lambilly/ha-monitor-display/hardware/3.5寸SPI屏幕参数1.jpg

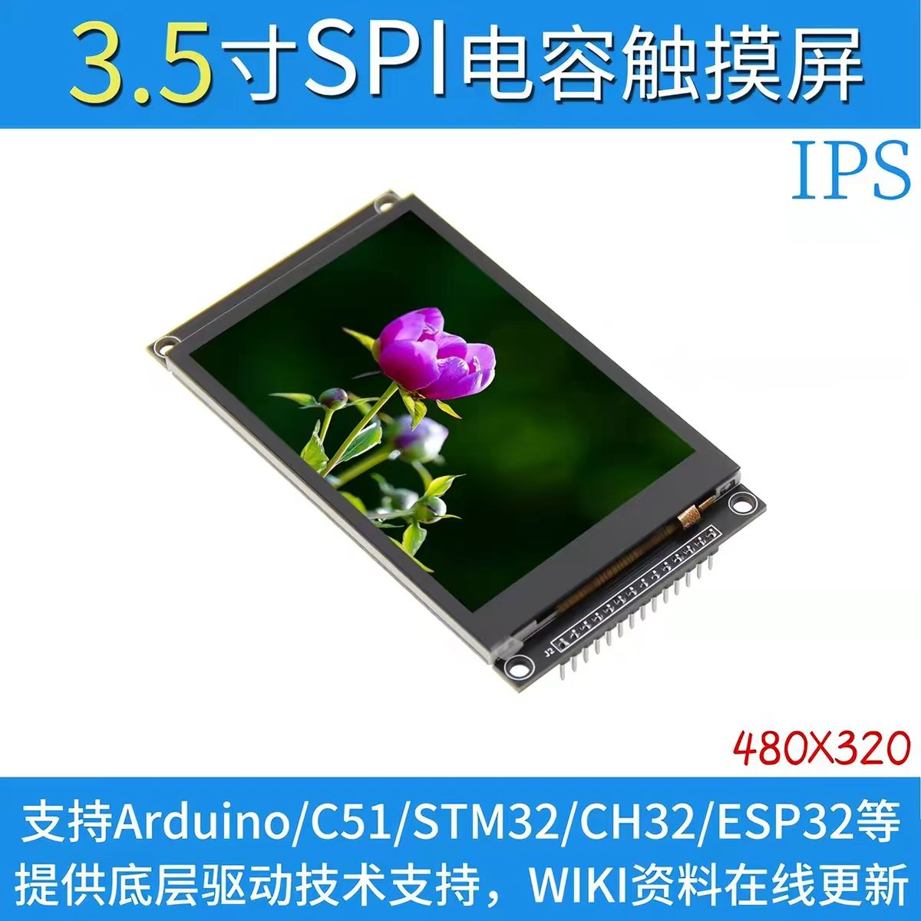
hardware/3.5寸SPI屏幕参数1.jpg
