lambilly/ha-monitor-display/hardware/INA226_1.jpg

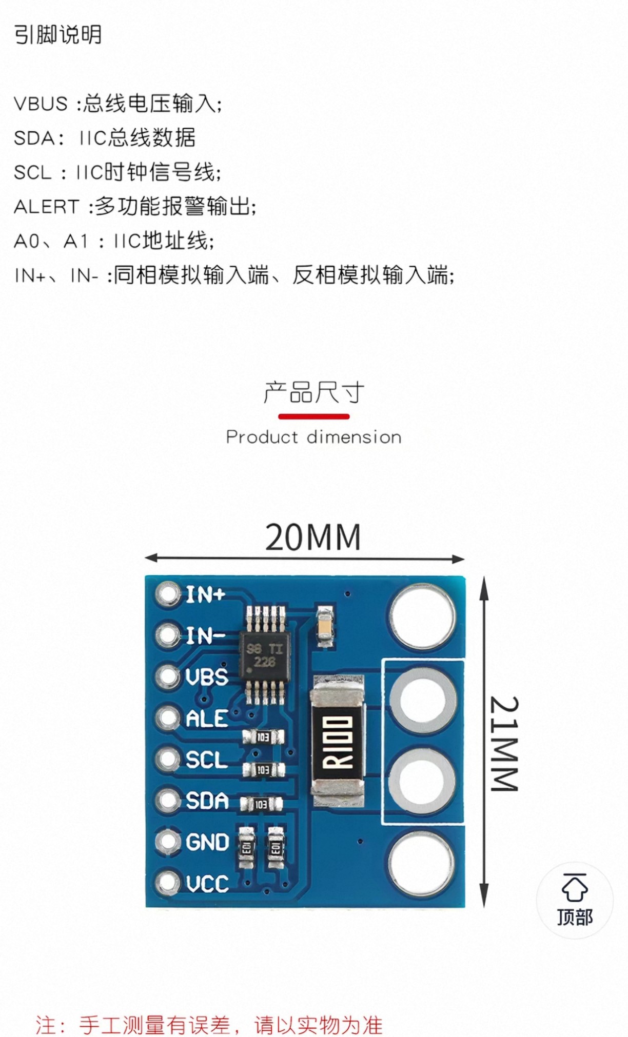
hardware/INA226_1.jpg
