lambilly/ha-monitor-display/hardware/INA226_2.jpg

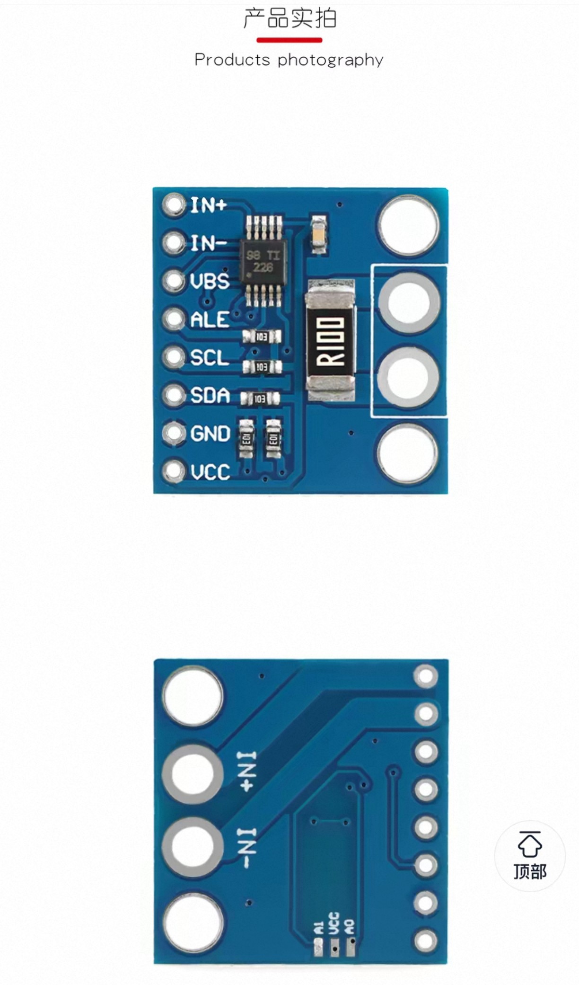
hardware/INA226_2.jpg
