lambilly/ha-monitor-display/hardware/TYPEC充电口1.png

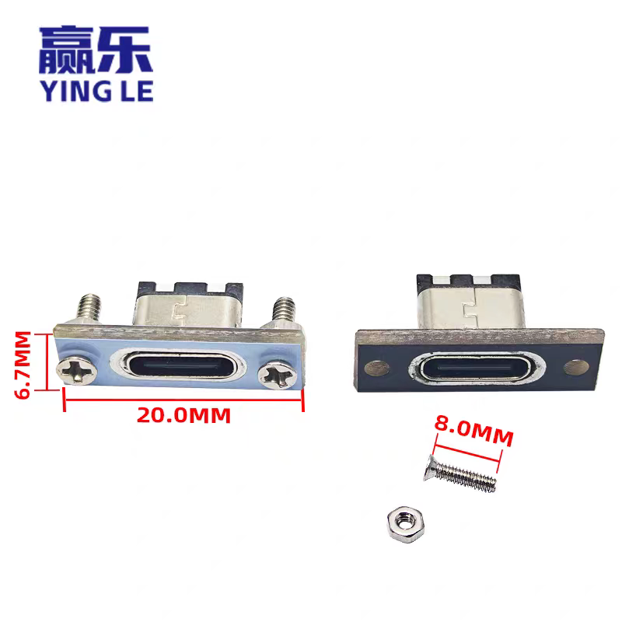
hardware/TYPEC充电口1.png
