lambilly/ha-monitor-display/hardware/TYPEC充电口2.png

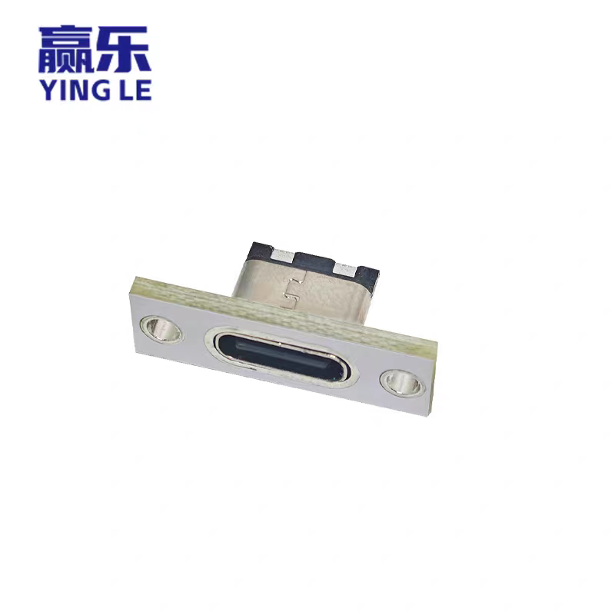
hardware/TYPEC充电口2.png
