lambilly/ha-monitor-display/hardware/屏幕镜像1-家居.png

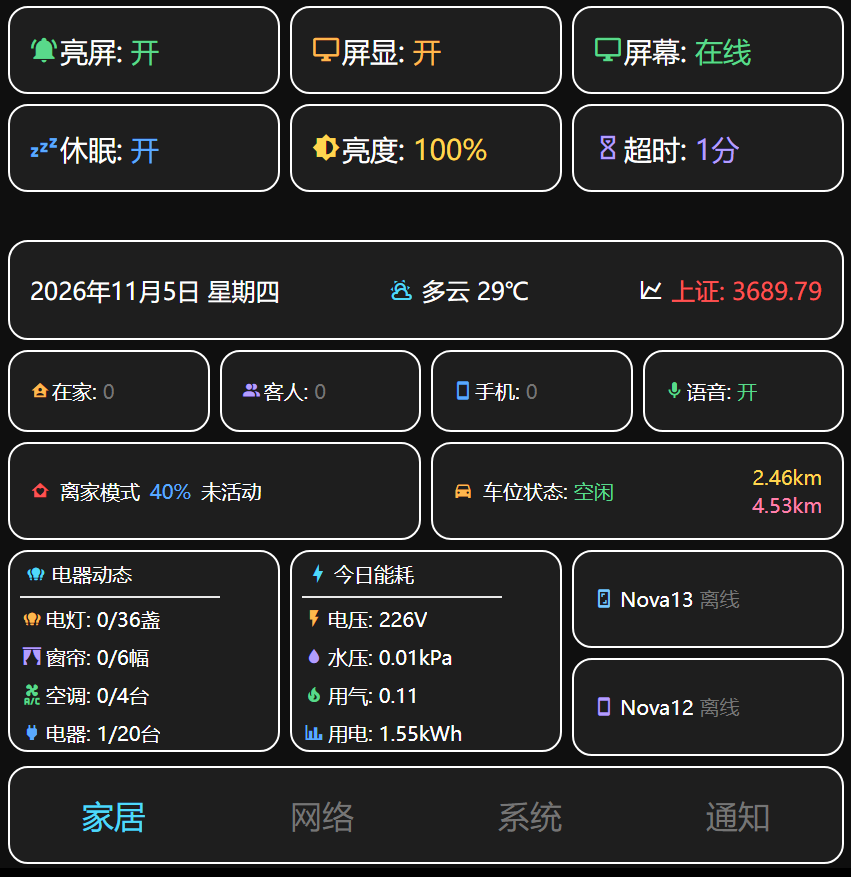
hardware/屏幕镜像1-家居.png
