lambilly/ha-monitor-display/hardware/屏幕镜像2-网络.png

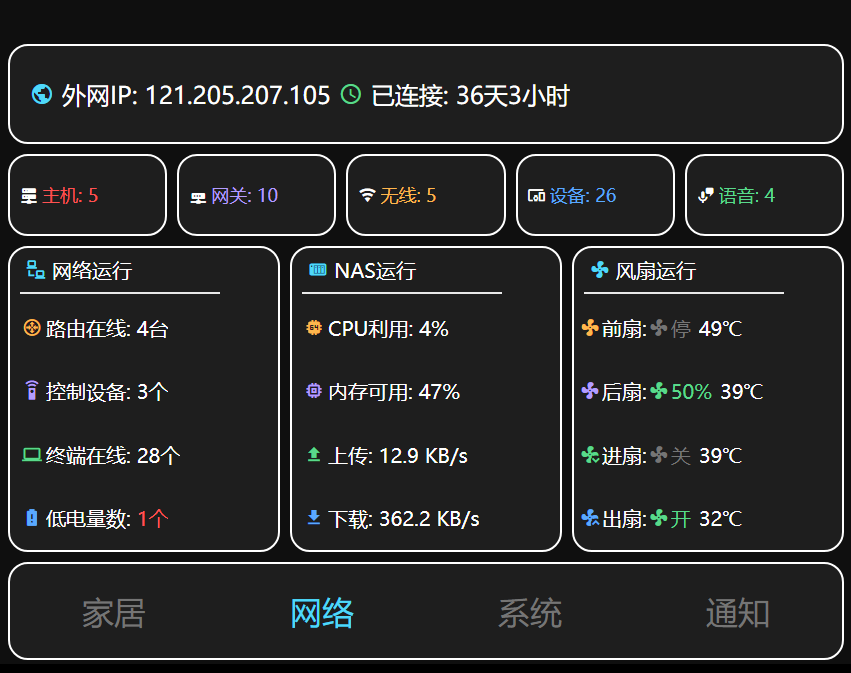
hardware/屏幕镜像2-网络.png
