lambilly/ha-monitor-display/hardware/屏幕镜像3-系统.png

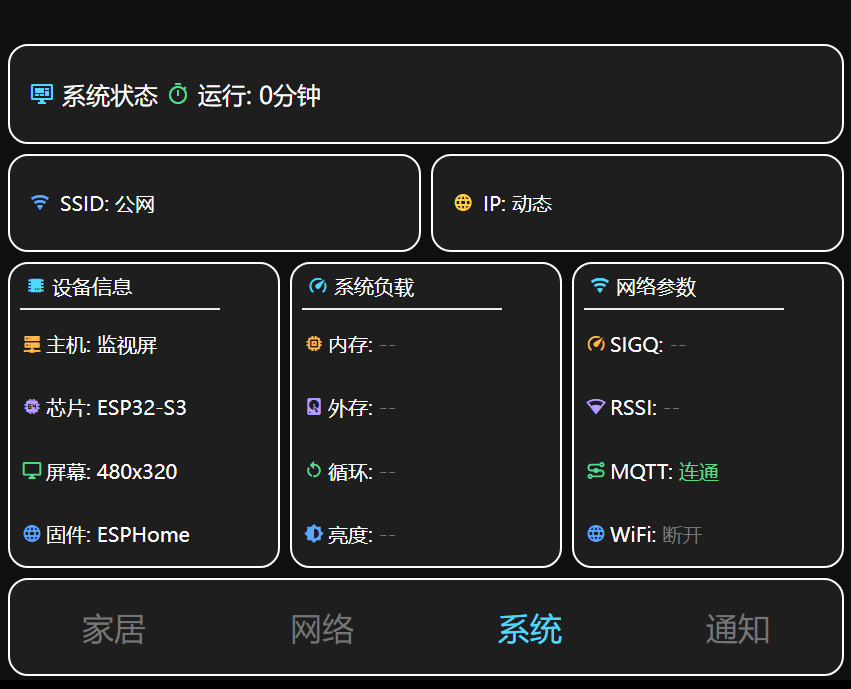
hardware/屏幕镜像3-系统.png
