lambilly/ha-monitor-display/hardware/屏幕镜像4-通知.png

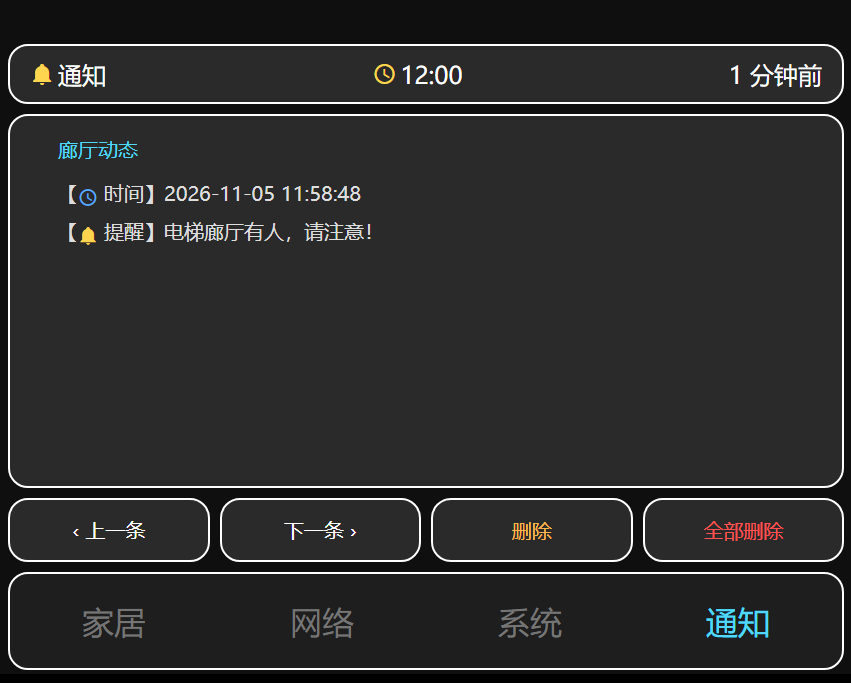
hardware/屏幕镜像4-通知.png
