lambilly/ha-monitor-display/hardware/硬件正面.jpg

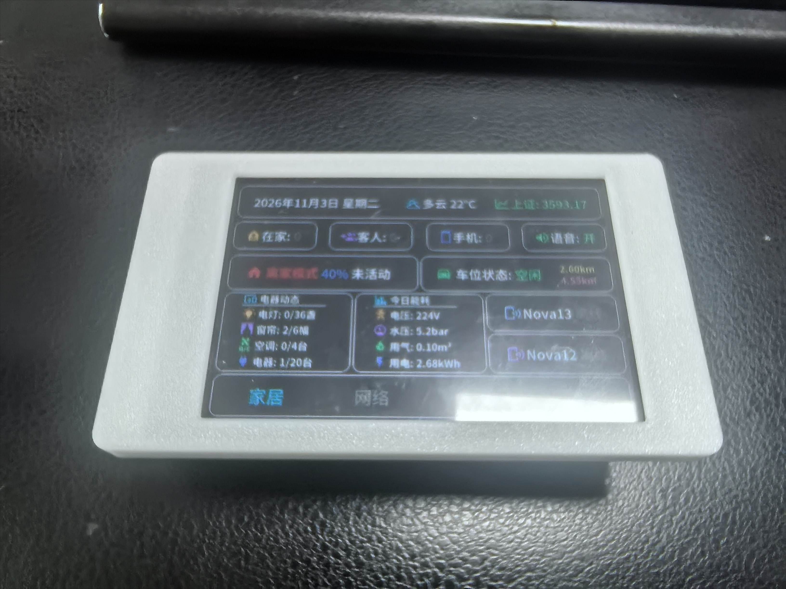
hardware/硬件正面.jpg
