lambilly/ha-monitor-display/hardware/硬件背面1.jpg

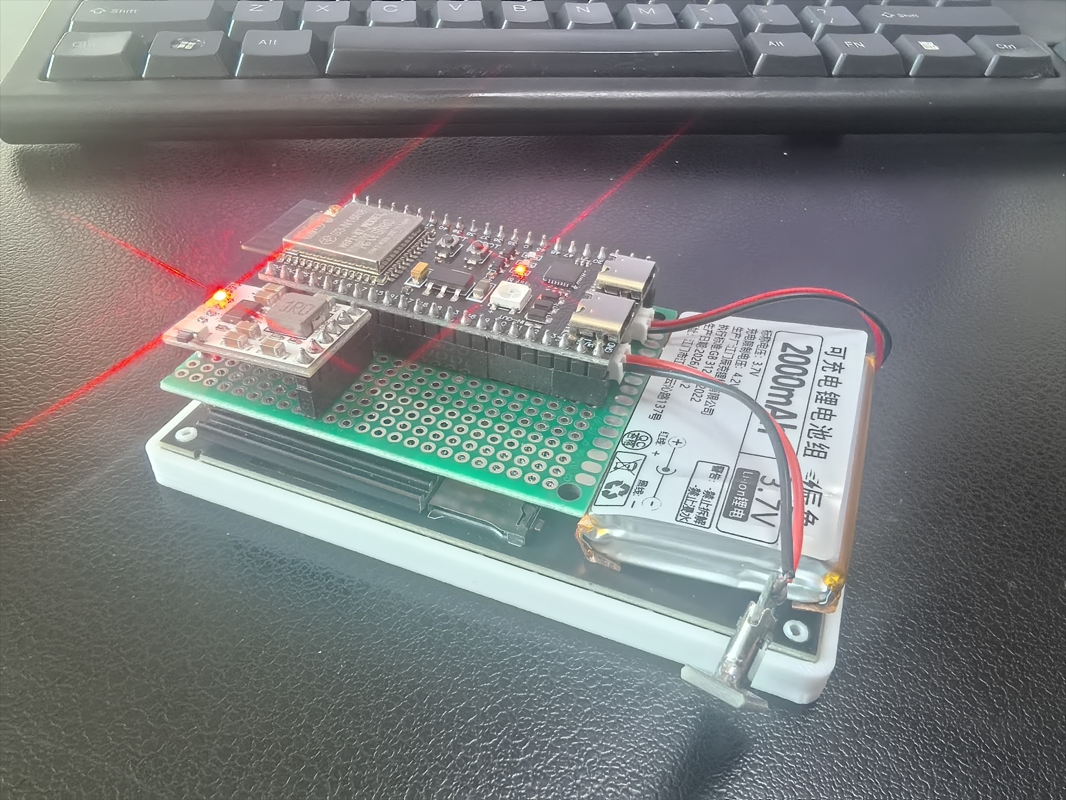
hardware/硬件背面1.jpg
