lambilly/ha-monitor-display/hardware/硬件背面2.jpg

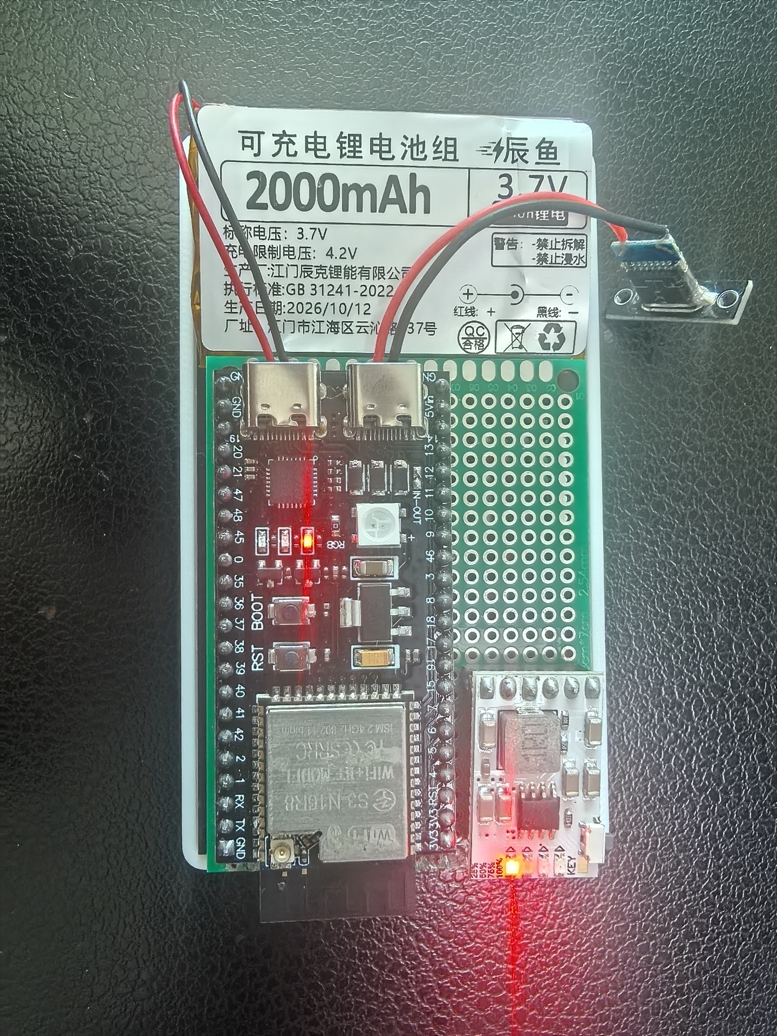
hardware/硬件背面2.jpg
