lambilly/ha-monitor-display/hardware/硬件背面.jpg

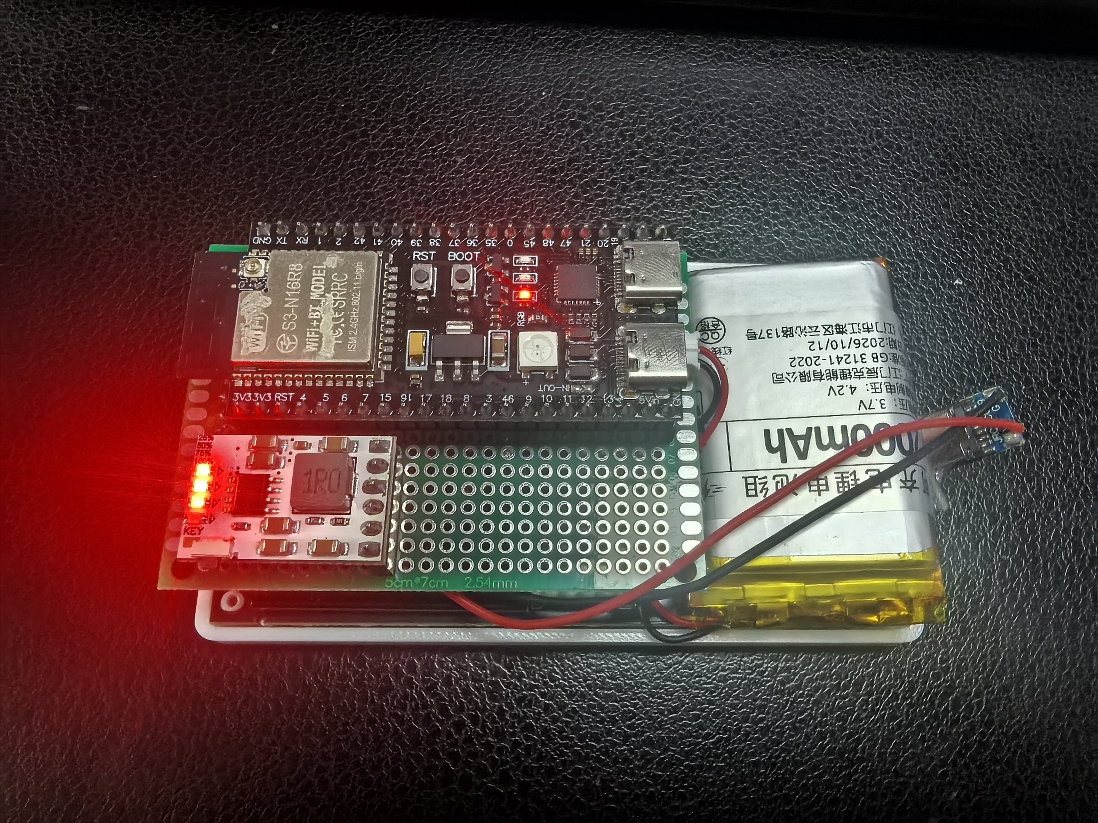
hardware/硬件背面.jpg
