lambilly/ha-monitor-display/hardware/TYPE C 母固定板.pdf

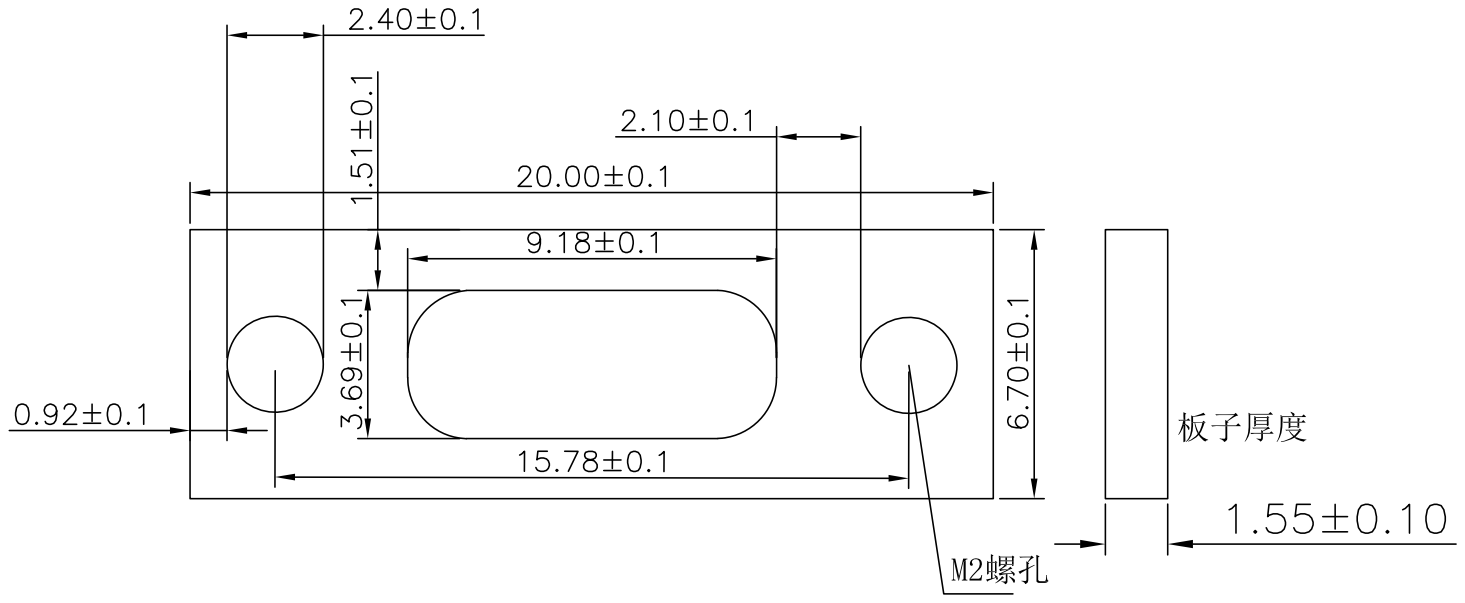
[picture p21: page 1]
