lambilly/ha-monitor-display/(list of files, drawings)

Other design files:
IP5406/KiCad/IP5406_PSU.dsn
