lambilly/ha-monitor-display/IP5406/KiCad/IP5406_PSU.kicad_pcb

## KiCad design IP5406/KiCad/IP5406_PSU.kicad_pcb (2026-11-04, last stored version)

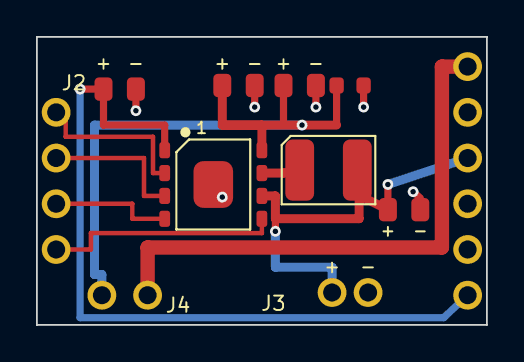
[picture p22: board IP5406_PSU.kicad_pcb from above]

Board: 2 copper layers, 25.0 x 16.0 mm, 11 parts (0 on the bottom side), 10 nets.

Parts:
C1: 22uF; C1
C2: 10uF; C2
C3: 22uF; C3
C4: 22uF; C4
C5: 100nF; C5
J1: 6PAD; J1
J2: SPARE4; J2
J3: PH2.0; J3
J4: SW_JUMPER; J4
L1: 1uH/4A; L1
U1: IP5406; U1

Connections:
BAT: C2.1, J1.3, J3.1, L1.2, U1.6
DCP: J2.1, U1.2
GND: C1.2, C2.2, C3.2, C4.2, C5.2, J1.2, J1.4, J1.5, J3.2, U1.9
KEY: J2.2, U1.3
LED1: J2.3, U1.4
LED2: J2.4, U1.5
OUT_SW: J1.1, J4.2
SW: L1.1, U1.7
VIN: C1.1, J1.6, U1.1
VOUT: C3.1, C4.1, C5.1, J4.1, U1.8
