lambilly/ha-monitor-display/ha-monitor-display.yaml

# ==========================================================
# 版本：v2.2.0 AUDIO（2026-11-07）
#   新增声音输出：MAX98357A I2S 数字功放 + 4Ω 3W 喇叭
#     · speaker(i2s_audio) → mixer → media_player(speaker)
#     · 双 pipeline（media + announcement），FLAC 由 HA 转码
#     · 内置音效 sounds/ding|notify|alarm.wav（48k/mono/16bit）
#     · SD 脚 GPIO21 空闲 3s 自动关功放（待机 <1µA）
#   上一版：v2.1 远程控制通道（HA 侧 monitor_display_control.yaml）
#   上一定版：v1.1.1（2026-11-01，续航优化，已出包）
# ==========================================================
# 主配置：设备 / 网络 / 硬件 / HA 实体
# 页面布局拆分到 ui_ha_monitor/ 目录，改界面只需改对应文件：
#   ui_ha_monitor/ui_common.yaml     公共资源（字体、全局变量、时钟刷新）
#   ui_ha_monitor/page_dashboard.yaml       页面1 家居
#   ui_ha_monitor/page_network.yaml         页面2 网络
#   ui_ha_monitor/page_system.yaml          页面3 系统
#
# ⚠️ 本项目 UI 独占 ui_ha_monitor/；口袋版 pocket-homeassistant 用 ui_pocket/，
#    两者不可混用（2026-11-12 拆分，此前共用 ui/ 导致互相覆盖）。
#
# 接入方式（方案C，双通道并存）：
#   api  : 本地局域网走 ESPHome Native API（连 Home Assistant，低延迟）
#   mqtt : 外网走 MQTT/TLS（8883），脱离 HA 也能远程读取/控制
# ==========================================================

packages:
  # 页面顺序 = LVGL 页面列表顺序，第一个为开机默认页（家居）
  page_dashboard: !include ui_ha_monitor/page_dashboard.yaml
  page_network: !include ui_ha_monitor/page_network.yaml
  page_system: !include ui_ha_monitor/page_system.yaml
  page_notify: !include ui_ha_monitor/page_notify.yaml      # v2.0 NOTIFY：第四页，不参与开机默认
  ui_common: !include ui_ha_monitor/ui_common.yaml
esphome:
  name: ha-monitor-display
  friendly_name: HA Monitor Display
  # v2.0 NOTIFY：通知环形缓冲与截断逻辑（8 槽，见 include/notify_store.h）
  includes:
    - include/notify_store.h
    - include/notify_charset.h      # notify_store.h 里 #include "notify_charset.h"，
                               # 必须一并登记，否则构建目录 src/ui/ 下没有这个文件

  # v2.1 远程控制通道：开机等 WiFi/MQTT 连上后回发一次状态帧，
  #   让 HA 里 5 个 mqtt 实体一上线就有值，不必等下一次操作。
  #   priority: -100 = 最后执行（其他 on_boot 都跑完）。
  on_boot:
    priority: -100
    then:
      - delay: 20s
      - script.execute: mqtt_pub_state

esp32:
  board: esp32-s3-devkitc-1
  variant: ESP32S3
  flash_size: 16MB
  framework:
    type: esp-idf

psram:
  mode: octal
  speed: 80MHz

logger:
  level: INFO
  logs:
    lvgl: WARN
    # 注：ESPHome 不允许某个 tag 的级别「比全局更细」
    #   （notify: DEBUG + 全局 INFO 会直接报 Failed config），
    #   所以通知链路的诊断日志一律用 ESP_LOGI，走全局 INFO 即可见。
    #   量很小：只在收到新消息、以及真的重绘时各打一两行。

api:
  encryption:
    key: !secret api_key
  # API 重连参数：网络抖动时自动恢复，不必改
  reboot_timeout: 15min

ota:
  - platform: esphome
    # 空的 encryption: 块（bare block）= 声明「OTA 必须加密，密钥继承 api 的 api_key」。
    #   ESPHome 在编译时把 api_key 填进来（见 components/esphome/ota 的 _resolve_encryption_key），
    #   所以既不会出现「密钥不一致」的校验错误，也不会被 Dashboard 判定为「另外配了一把密钥」。
    #   效果：明文 OTA 上传被拒绝；Dashboard 的两条安全提示都会消失。
    # 注意：从旧版 password 升级到加密 OTA，需 USB 线刷一次；之后无线 OTA 正常用。
    encryption:

# ==========================================================
# MQTT（外网远程通道）
# ==========================================================
mqtt:
  broker: !secret mqtt_broker      # 阿里云 DDNS 解析到你家公网 IP（地址放 secrets.yaml）
  port: !secret mqtt_port           # secrets.yaml 里配，明文 1883
  username: !secret mqtt_username
  password: !secret mqtt_password
  # topic_prefix 只影响本机"对外发布"的主题前缀。
  # 注意：本机不再向 HA 暴露任何实体（全部 internal: true），
  #       所以 discovery 关掉，避免在 HA 里生成一堆没用的空实体。
  topic_prefix: esphome/ha-monitor-display
  discovery: false
  keepalive: 30s
  reboot_timeout: 0s              
  clean_session: true
  # --- 主题规划 ---
  log_topic:
    topic: esphome/ha-monitor-display/logs
    level: INFO

  # ==========================================================
  # 订阅 HA 推送的数据帧
  # ==========================================================
  on_json_message:
    topic: home/ha-monitor-display
    then:
      - lambda: |-
          // 平铺赋值：每个 JSON key → 一个 ha_* 全局变量
          //   数值：is<float>() 判断，不可用（JSON null）时给 NAN，
          //        与页面里的 std::isfinite() 判断天然衔接
          //   布尔：| false 默认值操作符
          //   文本：is<const char *>() 判断，缺省给空串
          id(hd_ts) = x["ts"] | 0u;
          if (x["fan1_rpm"].is<float>()) id(hd_fan1_rpm) = x["fan1_rpm"].as<float>();
          else id(hd_fan1_rpm) = NAN;
          if (x["fan2_rpm"].is<float>()) id(hd_fan2_rpm) = x["fan2_rpm"].as<float>();
          else id(hd_fan2_rpm) = NAN;
          if (x["fan1_speed"].is<float>()) id(hd_fan1_speed) = x["fan1_speed"].as<float>();
          else id(hd_fan1_speed) = NAN;
          if (x["fan2_speed"].is<float>()) id(hd_fan2_speed) = x["fan2_speed"].as<float>();
          else id(hd_fan2_speed) = NAN;
          if (x["temp_front"].is<float>()) id(hd_temp_front) = x["temp_front"].as<float>();
          else id(hd_temp_front) = NAN;
          if (x["temp_back"].is<float>()) id(hd_temp_back) = x["temp_back"].as<float>();
          else id(hd_temp_back) = NAN;
          if (x["temp_in"].is<float>()) id(hd_temp_in) = x["temp_in"].as<float>();
          else id(hd_temp_in) = NAN;
          if (x["temp_out"].is<float>()) id(hd_temp_out) = x["temp_out"].as<float>();
          else id(hd_temp_out) = NAN;
          if (x["family_home"].is<float>()) id(hd_family_home) = x["family_home"].as<float>();
          else id(hd_family_home) = NAN;
          if (x["guest_visit"].is<float>()) id(hd_guest_visit) = x["guest_visit"].as<float>();
          else id(hd_guest_visit) = NAN;
          if (x["phone_online"].is<float>()) id(hd_phone_online) = x["phone_online"].as<float>();
          else id(hd_phone_online) = NAN;
          if (x["server_count"].is<float>()) id(hd_server_count) = x["server_count"].as<float>();
          else id(hd_server_count) = NAN;
          if (x["gateway_count"].is<float>()) id(hd_gateway_count) = x["gateway_count"].as<float>();
          else id(hd_gateway_count) = NAN;
          if (x["ap_count"].is<float>()) id(hd_ap_count) = x["ap_count"].as<float>();
          else id(hd_ap_count) = NAN;
          if (x["monitor_count"].is<float>()) id(hd_monitor_count) = x["monitor_count"].as<float>();
          else id(hd_monitor_count) = NAN;
          if (x["light_on"].is<float>()) id(hd_light_on) = x["light_on"].as<float>();
          else id(hd_light_on) = NAN;
          if (x["curtain_closed"].is<float>()) id(hd_curtain_closed) = x["curtain_closed"].as<float>();
          else id(hd_curtain_closed) = NAN;
          if (x["climate_on"].is<float>()) id(hd_climate_on) = x["climate_on"].as<float>();
          else id(hd_climate_on) = NAN;
          if (x["equipment_on"].is<float>()) id(hd_equipment_on) = x["equipment_on"].as<float>();
          else id(hd_equipment_on) = NAN;
          // 设备总数（HA 统计传感器属性：xxx_all_count），屏幕显示 "开/总数"
          if (x["light_all"].is<float>()) id(hd_light_all) = x["light_all"].as<float>();
          else id(hd_light_all) = NAN;
          if (x["curtain_all"].is<float>()) id(hd_curtain_all) = x["curtain_all"].as<float>();
          else id(hd_curtain_all) = NAN;
          if (x["climate_all"].is<float>()) id(hd_climate_all) = x["climate_all"].as<float>();
          else id(hd_climate_all) = NAN;
          if (x["equipment_all"].is<float>()) id(hd_equipment_all) = x["equipment_all"].as<float>();
          else id(hd_equipment_all) = NAN;
          if (x["weather_temp"].is<float>()) id(hd_weather_temp) = x["weather_temp"].as<float>();
          else id(hd_weather_temp) = NAN;
          if (x["outdoor_temp"].is<float>()) id(hd_outdoor_temp) = x["outdoor_temp"].as<float>();
          else id(hd_outdoor_temp) = NAN;
          if (x["energy_today"].is<float>()) id(hd_energy_today) = x["energy_today"].as<float>();
          else id(hd_energy_today) = NAN;
          if (x["gas_today"].is<float>()) id(hd_gas_today) = x["gas_today"].as<float>();
          else id(hd_gas_today) = NAN;
          if (x["voltage"].is<float>()) id(hd_voltage) = x["voltage"].as<float>();
          else id(hd_voltage) = NAN;
          if (x["water_pressure"].is<float>()) id(hd_water_pressure) = x["water_pressure"].as<float>();
          else id(hd_water_pressure) = NAN;
          if (x["xuanyi_dist"].is<float>()) id(hd_xuanyi_dist) = x["xuanyi_dist"].as<float>();
          else id(hd_xuanyi_dist) = NAN;
          if (x["byd_dist"].is<float>()) id(hd_byd_dist) = x["byd_dist"].as<float>();
          else id(hd_byd_dist) = NAN;
          if (x["wan_uptime"].is<float>()) id(hd_wan_uptime) = x["wan_uptime"].as<float>();
          else id(hd_wan_uptime) = NAN;
          if (x["asr_count"].is<float>()) id(hd_asr_count) = x["asr_count"].as<float>();
          else id(hd_asr_count) = NAN;
          if (x["router_count"].is<float>()) id(hd_router_count) = x["router_count"].as<float>();
          else id(hd_router_count) = NAN;
          if (x["device_ctrl"].is<float>()) id(hd_device_ctrl) = x["device_ctrl"].as<float>();
          else id(hd_device_ctrl) = NAN;
          if (x["terminal_count"].is<float>()) id(hd_terminal_count) = x["terminal_count"].as<float>();
          else id(hd_terminal_count) = NAN;
          if (x["low_battery"].is<float>()) id(hd_low_battery) = x["low_battery"].as<float>();
          else id(hd_low_battery) = NAN;
          if (x["nas_cpu"].is<float>()) id(hd_nas_cpu) = x["nas_cpu"].as<float>();
          else id(hd_nas_cpu) = NAN;
          if (x["nas_mem"].is<float>()) id(hd_nas_mem) = x["nas_mem"].as<float>();
          else id(hd_nas_mem) = NAN;
          if (x["screen_bright"].is<float>()) id(hd_screen_bright) = x["screen_bright"].as<float>();
          else id(hd_screen_bright) = NAN;
          if (x["nas_download"].is<float>()) id(hd_nas_download) = x["nas_download"].as<float>();
          else id(hd_nas_download) = NAN;
          if (x["nas_upload"].is<float>()) id(hd_nas_upload) = x["nas_upload"].as<float>();
          else id(hd_nas_upload) = NAN;

          // 开关类三态：-1=实体不存在/无数据，0=关，1=开
          //（HA 侧宏 sw() 在实体不可用时输出 null，此处落成 -1）
          // 在线设备指示两格（通用槽位，名称由 HA 下发，固件不写死任何具体设备）
          id(hd_device_a_online) = x["device_a_online"].is<int>() ? x["device_a_online"].as<int>() : -1;
          id(hd_device_b_online) = x["device_b_online"].is<int>() ? x["device_b_online"].as<int>() : -1;
          id(hd_wan_status)      = x["wan_status"].is<int>()      ? x["wan_status"].as<int>()      : -1;
          id(hd_voice_broadcast) = x["voice_broadcast"].is<int>() ? x["voice_broadcast"].as<int>() : -1;
          id(hd_fan_in_switch)   = x["fan_in_switch"].is<int>()   ? x["fan_in_switch"].as<int>()   : -1;
          id(hd_fan_out_switch)  = x["fan_out_switch"].is<int>()  ? x["fan_out_switch"].as<int>()  : -1;

          id(hd_time_text) = x["time_text"].is<const char *>() ? std::string(x["time_text"].as<const char *>()) : std::string();
          // 在线设备两格的显示名称（HA 下发；留空则界面用默认「设备1/设备2」）
          id(hd_device_a_name) = x["device_a_name"].is<const char *>() ? std::string(x["device_a_name"].as<const char *>()) : std::string();
          id(hd_device_b_name) = x["device_b_name"].is<const char *>() ? std::string(x["device_b_name"].as<const char *>()) : std::string();
          id(hd_external_ip) = x["external_ip"].is<const char *>() ? std::string(x["external_ip"].as<const char *>()) : std::string();
          id(hd_weather) = x["weather"].is<const char *>() ? std::string(x["weather"].as<const char *>()) : std::string();
          id(hd_stock) = x["stock"].is<const char *>() ? std::string(x["stock"].as<const char *>()) : std::string();
          // 上证涨跌幅：JSON 数字直接取；HA 若发字符串（如 "0.35"）用 atof 兜底；null/缺失 → NAN（界面显灰）
          if (x["stock_chg"].is<float>())             id(hd_stock_chg) = x["stock_chg"].as<float>();
          else if (x["stock_chg"].is<const char *>()) id(hd_stock_chg) = atof(x["stock_chg"].as<const char *>());
          else                                        id(hd_stock_chg) = NAN;
          id(hd_home_mode) = x["home_mode"].is<const char *>() ? std::string(x["home_mode"].as<const char *>()) : std::string();
          id(hd_activity_log) = x["activity_log"].is<const char *>() ? std::string(x["activity_log"].as<const char *>()) : std::string();
          // 音量百分比：数字直接用；HA 若发 "65%"/"65" 之类字符串则提数字；null/缺失/非数字 → NAN
          {
            float mv = NAN;
            if (x["mode_volume"].is<float>()) {
              mv = x["mode_volume"].as<float>();
            } else if (x["mode_volume"].is<const char *>()) {
              const char *p = x["mode_volume"].as<const char *>();
              if (p != nullptr && ((p[0] >= '0' && p[0] <= '9') || p[0] == '-')) mv = atof(p);
            }
            id(hd_mode_volume) = std::isfinite(mv) ? mv : NAN;
            static bool mv_warned = false;
            if (!std::isfinite(mv) && !mv_warned) {
              mv_warned = true;
              ESP_LOGW("ha_data", "mode_volume 缺失或非数值（HA 侧 sensor.ju_jia_mo_shi 无 volume_percent 属性？）");
            }
          }
          id(hd_parking_status) = x["parking_status"].is<const char *>() ? std::string(x["parking_status"].as<const char *>()) : std::string();

          id(ha_data_last_ms) = millis();
          ESP_LOGD("ha_data", "收到数据帧 ts=%u", (unsigned) id(hd_ts));

  # ==========================================================
  # 订阅通知消息（v2.0 NOTIFY）
  # ----------------------------------------------------------
  #   主题 home/ha-monitor-display/notify，QoS1，retain=false。
  #   MQTT 主题精确匹配，上面的数据帧订阅收不到子主题，两条互不干扰。
  #   载荷优先按 JSON {title,message,ts} 解析（Node-RED 子流程的格式）；
  #   不是 JSON 就整段当正文，HA 原生 mqtt.publish 发纯文本也能上屏。
  #   入库统一走 ns_notify（include/notify_store.h）：8 槽环形 + UTF-8 安全截断 + 重复丢弃。
  # ==========================================================
  on_message:
    - topic: home/ha-monitor-display/notify
      then:
        - lambda: |-
            std::string nt;
            std::string nm;
            uint32_t nts = 0;
            bool parsed = false;

            if (!x.empty() && x[0] == '{') {
              parsed = esphome::json::parse_json(x, [&](JsonObject root) -> bool {
                if (root["title"].is<const char *>()) nt = root["title"].as<const char *>();
                if (root["message"].is<const char *>()) nm = root["message"].as<const char *>();
                // ts 统一归一成「秒」：Node-RED 里 Date.now() 给的是 13 位毫秒，
                //   直接塞进 uint32_t 会溢出成乱七八糟的值（时间显示错乱甚至空白），
                //   所以先按 64 位读，超过 1e11 就除 1000。
                if (root["ts"].is<const char *>()) {
                  const unsigned long long raw =
                      strtoull(root["ts"].as<const char *>(), nullptr, 10);
                  nts = static_cast<uint32_t>(raw > 100000000000ULL ? raw / 1000 : raw);
                } else if (!root["ts"].isNull()) {
                  const uint64_t raw = root["ts"].as<uint64_t>();
                  nts = static_cast<uint32_t>(raw > 100000000000ULL ? raw / 1000 : raw);
                }
                return true;
              });
            }
            if (!parsed || (nt.empty() && nm.empty())) {
              nt.clear();
              nm = x;                                  // 非 JSON 载荷：整段当正文
            }
            if (nt.empty() && nm.empty()) return;

            // 诊断（第九轮加）：入库前的「原始」message 有几个换行 ——
            //   0 个 = 换行在上游（HA 模板 / NR 上游节点）就丢了，设备端无从恢复；
            //   >0 个但入库后变少 = 设备端处理链有问题（目前没有这种迹象）。
            {
              int raw_nl = 0;
              for (size_t k = 0; k < nm.size(); k++)
                if (nm[k] == '\n') raw_nl++;
              ESP_LOGI("notify", "原始 message %u字节/%d个换行 标题[%s]",
                       (unsigned) nm.size(), raw_nl, nt.c_str());
            }

            // 去重在 push 内部做（要拿归一 + 折行后的值比才准，见 notify_store.h）
            ns_notify::push(nt, nm, nts);
            {
              // 诊断日志（用户 11-01 要求抓串口）：一行看完入库结果
              //   正文 N 字节 / M 行 —— 行数是数 '\n' 得来的
              //   若 行数=1 而字节数很大，说明 wrap_hard 没跑到（折行没生效）
              //   再往下一条「全文」把正文原样吐出来，串口里会真的断成多行
              const std::string &mm = ns_notify::at(0).msg;
              int nl = 0;
              for (size_t k = 0; k < mm.size(); k++)
                if (mm[k] == '\n') nl++;
              ESP_LOGI("notify", "入列 共%d条 未读%d条 [%s] 正文%u字节/%d行 首行:%.46s",
                       ns_notify::count, ns_notify::unread,
                       ns_notify::at(0).title.c_str(),
                       (unsigned) mm.size(), nl + 1, mm.c_str());
              ESP_LOGI("notify", "全文:\n%s", mm.c_str());
            }

            // 通知亮屏与跳页见下方动作链（v3.3）：这里只管入库
        # ==========================================================
        # 通知亮屏并直跳通知页（v3.3）
        #   以前只唤醒背光，15 秒里停在原页面，用户得先摸一下 TAB 才看得见通知。
        #   现在：关屏状态下收到通知 → 切 notify_page + 唤醒（保持 15s，见 wake_screen）。
        #   · 条件里带 ui_screen_off：屏亮着时不抢页面，避免用户正看家居页被顶走；
        #   · lvgl.page.show 必须走动作队列，不能在 MQTT 回调的 lambda 里直接 lv_scr_load；
        #   · notify_page 的 on_load 会自动置 ui_current_page=4 并清未读，TAB 高亮同步。
        # ==========================================================
        - if:
            condition:
              lambda: 'return id(notify_wake_on_msg).state && id(ui_screen_off) && id(lvgl_ready);'
            then:
              - lvgl.page.show: notify_page
              - script.execute: wake_screen

    # ==========================================================
    # v2.1 远程控制通道（屏幕带出门后仍可控制）
    # ----------------------------------------------------------
    #   痛点：亮度/亮屏时间/两个开关原先只走 Native API，要求 HA 能
    #     主动连到屏幕。屏幕一出门（无公网 IP、穿过 NAT）这条线就断，
    #     而 MQTT 是设备主动往外连，所以数据一直好、控制全废。
    #   做法：把这 5 项也挂到 MQTT 上，payload 就是简单值，
    #     应用后立刻回发状态帧（retain），HA 面板实时跟随。
    #   主题（全部 retain，QoS1）：
    #     .../cmd/light     ON | OFF                屏幕开关（开=唤醒到上次亮度）
    #     .../cmd/bright    10~100                  亮度百分比
    #     .../cmd/sleep     15~900                  熄屏超时（秒）
    #     .../cmd/autosleep ON | OFF                自动休眠总开关
    #     .../cmd/wake      ON | OFF                收到通知时亮屏
    #   注：cmd 主题 retain，所以设备重连/重启会重放 HA 最后一次下发的值，
    #     即「重启后以 HA 侧为准」，比本机 restore_value 更可预期。
    # ==========================================================
    - topic: home/ha-monitor-display/cmd/light
      qos: 1
      then:
        - lambda: |-
            const bool on = (x == "ON" || x == "on" || x == "1");
            ESP_LOGI("cmd", "remote light -> %s", on ? "ON" : "OFF");
            if (on) {
              if (id(ui_screen_off)) {
                id(wake_screen).execute();
              } else {
                auto call = id(lcd_backlight).turn_on();
                call.set_brightness(id(ui_saved_brightness));
                call.perform();
              }
            } else {
              id(sleep_screen).execute();
            }
        - script.execute: mqtt_pub_state

    - topic: home/ha-monitor-display/cmd/bright
      qos: 1
      then:
        - lambda: |-
            auto v = esphome::parse_number<float>(x);
            if (!v.has_value()) return;
            float pct = *v;
            if (pct < 10.0f) pct = 10.0f;      // 与滑块实体 min 一致，防调到看不见
            if (pct > 100.0f) pct = 100.0f;
            ESP_LOGI("cmd", "remote brightness -> %.0f%%", pct);
            // 直接走滑块实体的 set_action：ui_saved_brightness 与灯实体一次到位
            auto call = id(screen_brightness_number).make_call();
            call.set_value(pct);
            call.perform();
        - script.execute: mqtt_pub_state

    - topic: home/ha-monitor-display/cmd/sleep
      qos: 1
      then:
        - lambda: |-
            auto v = esphome::parse_number<float>(x);
            if (!v.has_value()) return;
            float s = *v;
            if (s < 15.0f) s = 15.0f;
            if (s > 900.0f) s = 900.0f;
            ESP_LOGI("cmd", "remote sleep timeout -> %.0fs", s);
            auto call = id(sleep_timeout_number).make_call();
            call.set_value(s);
            call.perform();
        - script.execute: mqtt_pub_state

    - topic: home/ha-monitor-display/cmd/autosleep
      qos: 1
      then:
        - lambda: |-
            const bool on = (x == "ON" || x == "on" || x == "1");
            ESP_LOGI("cmd", "remote auto sleep -> %s", on ? "ON" : "OFF");
            if (on) id(auto_sleep_switch).turn_on();
            else id(auto_sleep_switch).turn_off();
        - script.execute: mqtt_pub_state

    - topic: home/ha-monitor-display/cmd/wake
      qos: 1
      then:
        - lambda: |-
            const bool on = (x == "ON" || x == "on" || x == "1");
            ESP_LOGI("cmd", "remote notify wake -> %s", on ? "ON" : "OFF");
            if (on) id(notify_wake_on_msg).turn_on();
            else id(notify_wake_on_msg).turn_off();
        - script.execute: mqtt_pub_state

wifi:
  ssid: !secret wifi_ssid
  password: !secret wifi_password
  # modem-sleep：无流量时 WiFi 进省电态，待机电流约省 1/3。
  # 代价仅是响应略慢（数据帧 5s 一推，感知不到），MQTT keepalive 15s 不受影响。
  power_save_mode: light
  ap:
    ssid: HA Monitor Fallback
    password: !secret ap_password

captive_portal:
web_server:
  port: 80
  version: 3
  auth:
    # digest：密码只以哈希形式走网络（basic 是 Base64，等于明文）
    # 2027.1.0 起 ESPHome 的默认值也会变成 digest，现在显式指定可提前对齐。
    # 注意：用 curl 等 REST 客户端访问需加 --digest（例：curl --digest -u admin:密码 http://IP/）。
    type: digest
    username: admin
    password: !secret web_password

# --- 屏幕硬件配置 ---
spi:
  id: display_spi
  clk_pin: GPIO12
  mosi_pin: GPIO11
  miso_pin: GPIO13

i2c:
  id: touch_i2c
  scl: GPIO6
  sda: GPIO7
  frequency: 100kHz

output:
  - platform: ledc
    pin:
      number: GPIO15
    id: lcd_backlight_pwm
    frequency: 20kHz

light:
  - platform: monochromatic
    id: lcd_backlight
    name: "Screen Light"
    icon: mdi:monitor
    output: lcd_backlight_pwm
    # ALWAYS_OFF：开机不自带满亮点亮，由 lvgl on_boot 按 ui_saved_brightness（默认 60%）点亮，
    # 避免开机先全亮一秒再暗下来的闪变。休眠/唤醒见 script sleep_screen / wake_screen。
    restore_mode: ALWAYS_OFF

display:
  - platform: mipi_spi
    id: lcd_display
    model: CUSTOM
    dimensions: 320x480
    spi_id: display_spi
    cs_pin: GPIO10
    dc_pin: GPIO9
    reset_pin: GPIO8
    data_rate: 40MHz
    transform:
      mirror_x: true
      mirror_y: false
      swap_xy: false
    rotation: 0
    color_order: bgr
    invert_colors: true
    auto_clear_enabled: false
    update_interval: never
    init_sequence:
      - [0xF0, 0xC3]
      - [0xF0, 0x96]
      - [0xB4, 0x02]
      - [0xB7, 0xC6]
      - [0xC0, 0xC0, 0x00]
      - [0xC1, 0x13]
      - [0xC2, 0xA7]
      - [0xC5, 0x21]
      - [0xE8, 0x40, 0x8A, 0x1B, 0x1B, 0x23, 0x0A, 0xAC, 0x33]
      - [0xE0, 0xD2, 0x05, 0x08, 0x06, 0x05, 0x02, 0x2A, 0x44, 0x46, 0x39, 0x15, 0x15, 0x2D, 0x32]
      - [0xE1, 0x96, 0x08, 0x0C, 0x09, 0x09, 0x25, 0x2E, 0x43, 0x42, 0x35, 0x11, 0x11, 0x28, 0x2E]
      - [0xF0, 0x3C]
      - [0xF0, 0x69]

touchscreen:
  - platform: ft63x6
    id: touch_panel
    i2c_id: touch_i2c
    address: 0x38
    display: lcd_display
    reset_pin: GPIO5
    update_interval: 20ms
    on_touch:
      - lambda: id(ui_touch_active) = true;
      # 熄屏状态下任意触摸立即点亮
      - if:
          condition:
            lambda: return id(ui_screen_off);
          then:
            - script.execute: wake_screen
    on_release:
      - lambda: id(ui_touch_active) = false;

# ==========================================================
# 声音输出：MAX98357A（I2S 数字功放）  v2.2.0 新增 2026-11-07
#   接线：VIN→5V(J1-1) / GND→GND(J1-2)
#         BCLK→GPIO39 / LRC→GPIO40 / DIN→GPIO41 / SD→GPIO21
#         喇叭 ± 接 BTL 输出——**两端都不可接地**，否则烧功放
#   省电：SD 由 GPIO21 控制，不播放时拉低 → 功放待机 <1µA
#         （悬空或接 VDD 会常耗 2.4mA，对 20mA 待机是 +12%）
#   引脚全部选在模块**右侧**，与左侧的 SPI(11/12/13) 和 I2C(6/7) 分开，
#     避免 BCLK 与 SCK(40MHz) 长距离并行串扰，走线也顺。
#     ⚠️ 原选 47/48/38 已废弃（v2.2.1 换掉），两个原因：
#        ① 47/48/38 正是 DevKitC-1 板载 WS2812 彩灯的脚（v1.0=48 / v1.1=38），
#          I2S 位流被 WS2812 误解析 → 灯变纯白常亮，且给数据线挂负载；
#        ② 若是 WROOM-2（N16R8V），GPIO47/48 在 VDD_SPI 1.8V 域，输出仅 1.8V，
#          驱动 MAX98357A(VIH=1.3V) 余量太小。
#     39/40/41 是 JTAG 复用脚，ESPHome 不用 JTAG（UART/OTA 烧录），可安全占用。
#     避开的：35/36/37(octal PSRAM)、19/20(USB)、0/3/45/46(strapping)、
#             43/44(UART0)、4(TF 卡预留，且已加 10k 上拉)
# ==========================================================
i2s_audio:
  # 注意：i2s_audio 是单实例组件（不是列表，写成 `- id:` 会校验失败）
  id: i2s_out
  i2s_lrclk_pin: GPIO40
  i2s_bclk_pin: GPIO39

speaker:
  - platform: i2s_audio
    id: spk_out
    i2s_audio_id: i2s_out
    i2s_dout_pin: GPIO41
    dac_type: external            # MAX98357A = 外部 DAC + D 类功放
    sample_rate: 48000
    bits_per_sample: 16bit
    channel: mono                 # 单喇叭，单声道省一半带宽与解码开销
    buffer_duration: 300ms
    timeout: 500ms

  # mixer：把「媒体」与「播报」两条流水线合成一路送给同一个喇叭。
  # 必须用 mixer —— ESPHome 不允许两条 pipeline 指向同一个 speaker 实例。
  # 两条都是 48kHz / mono，采样率一致，所以不需要 resampler。
  - platform: mixer
    id: spk_mix
    output_speaker: spk_out
    task_stack_in_psram: true
    source_speakers:
      - id: spk_media_in            # TTS / 音乐 / play_media 走这条
      - id: spk_announce_in         # 紧急播报走这条（可 ducking 压低媒体音量）

media_player:
  - platform: speaker
    id: mp_screen
    name: "Screen Speaker"
    icon: mdi:speaker
    # announcement_pipeline 在 schema 里是 Required，media 才是 Optional；
    # 两条都配上，TTS(走 media) 与紧急播报(走 announcement) 才能分别工作。
    media_pipeline:
      speaker: spk_media_in
      format: FLAC                # HA(≥2024.10) 负责转码，设备端只解码，省 CPU
      sample_rate: 48000
      num_channels: 1
    announcement_pipeline:
      speaker: spk_announce_in
      format: FLAC
      sample_rate: 48000
      num_channels: 1
    buffer_size: 120000           # 每条流水线 120KB（大块 malloc 落 PSRAM）
    task_stack_in_psram: true     # 8MB octal PSRAM，任务栈不占内部 RAM
    volume_initial: 60%
    # ⚠️ 上限压到 70%，不是 90%：
    #   4Ω/3W 喇叭在 5V 下满量程 3.2W，峰值电流 ≈1.26A@4Ω，
    #   电池 3.99V 要输出 1.7A 输入，会直接踩 IP5407 的过流/欠压打嗝。
    #   70% 音量 ≈ 1.5W 峰值，电池撑得住，响度对室内信息屏已经够。
    volume_max: 70%
    files:                        # 内置音效：断网 / HA 宕机也能响
      - id: snd_ding
        file: sounds/ding.wav
      - id: snd_notify
        file: sounds/notify.wav
      - id: snd_alarm
        file: sounds/alarm.wav

# 内置音效的调用方式（v2.2.1 删掉了 3 个 template button —— 它们只是手动试音键，
# 与 media_player 实体功能重复；自动化直接调下面的动作即可，能力一点没少）
# HA 自动化里要响，直接调动作：
#   action: media_player.speaker.play_on_device_media_file
#   data: { entity_id: media_player.ha_monitor_display_screen_speaker, media_file: snd_ding }
# TTS 播报：action: tts.speak（target: media_player.ha_monitor_display_screen_speaker）

# --- 时间 ---
# ==========================================================
# 时间：只用 SNTP，不依赖 HA
#   （原 platform: homeassistant 的 time 也需要 Native API，
#     出门后不可用；SNTP 只要设备能上网就能对时）
# ==========================================================
time:
  - platform: sntp
    id: system_time
    timezone: Asia/Shanghai
    servers:
      - ntp.aliyun.com
      - cn.pool.ntp.org
      - time.cloudflare.com

lvgl:
  displays: [lcd_display]
  touchscreens: [touch_panel]
  rotation: 270                     # 横屏 480x320（竖装倒置：由 90 翻 180°）
  buffer_size: "25%"
  draw_rounding: 8
  resume_on_input: false
  on_boot:
    - delay: 800ms
    - lambda:
        ESP_LOGI("custom", "LVGL is ready!");
        id(lvgl_ready) = true;
    # 开机默认进入家居页
    - lvgl.page.show: dashboard_page
    # 开机点亮背光：亮度取 ui_saved_brightness（默认 60%，熄屏恢复同源）
    - light.turn_on:
        id: lcd_backlight
        brightness: !lambda |-
          return id(ui_saved_brightness);
  default_font: ui_font_small
  theme:
    label:
      pressed:
        text_color: 0xFFFFFF

  # ==========================================================
  # 全局顶层：数据通道离线指示
  # ----------------------------------------------------------
  top_layer:
    widgets:
      # 离线图标（默认隐藏，由下方 interval 控制显隐）
      # mdi:cloud-off（实心断云）U+F1BF6；
      - label:
          id: offlink_icon
          align: TOP_RIGHT
          x: -9
          y: 6
          text: "\U000F1BF6"
          text_font: mdi_icons_12
          text_color: 0xFF5252
          hidden: true
      # 离线文字（与图标同一行，靠左显示"离线"两字）
      - label:
          id: offlink_text
          align: TOP_RIGHT
          x: -26
          y: 4
          text: "离线"
          text_font: ui_font_small
          text_color: 0xFF5252
          hidden: true

      # 未读红点（v2.0 NOTIFY）：压在 TAB「通知」键的右上角
      #   放在 top_layer 而不是 tab_bar.yaml 里 —— 片段被四页各 include 一次，
      #   带 id 会重复定义；这里单实例，四个页面顶部都能看到同一个点。
      #   x 跟着 TAB 走：TAB 第八轮右移 7px（≈1.2mm，通知键墨迹 379~419）
      #   第十轮：用户说「有新通知时能不能在 TAB 通知那里做个记号」——
      #   原来这个点只有 6px、还没描边，压在深色底上几乎看不见。改成 9px
      #   圆点 + 1px 深色描边（任何背景色下都能看出边界）。
      #   第十二轮（用户实测）：9px 时点儿落在「通知」两字正中间的上方，
      #   右移 18px、下移 2px 挪到两字右上角，同时放大到 11px 更好认。
      #   第十三轮：再左 1px、下 1px（439/273→438/274）；红点改浅绿 59D98B
      #   —— 红点在深色底上太像告警，绿点更接近「有新内容」的语义。
      - obj:
          id: notify_badge
          align: TOP_LEFT
          x: 438
          y: 274
          width: 11
          height: 11
          bg_color: 0x59D98B
          border_width: 1
          border_color: 0x1E1E1E
          outline_width: 0
          radius: 6
          scrollable: false
          hidden: true

# ==========================================================
# 未读红点巡检（v2.0 NOTIFY）
#   只看 unread 变化，没变化直接 return；进通知页即视为已读
# ==========================================================
interval:
  - interval: 1s
    then:
      - lambda: |-
          if (!id(lvgl_ready)) return;
          static int last_unread = -1;
          const int u = (id(ui_current_page) == 4) ? 0 : ns_notify::unread;
          if (u == last_unread) return;
          last_unread = u;
          if (u > 0) lv_obj_clear_flag(id(notify_badge), LV_OBJ_FLAG_HIDDEN);
          else       lv_obj_add_flag(id(notify_badge), LV_OBJ_FLAG_HIDDEN);

  # ----------------------------------------------------------
  # 功放使能跟随播放状态
  #   拉高 SD → 功放上电；停止播放 3 秒后拉低 → 待机 <1µA
  #   注意：不能用 media_player 的 on_turn_on/on_turn_off，
  #         那两个只在收到 power 命令时触发，play_media 不会触发。
  #         speaker.is_running() 才反映"真的在出声"。
  # ----------------------------------------------------------
  - interval: 1s
    then:
      - lambda: |-
          // 用软件标志记录 SD 状态：GPIO switch 的 state 字段在不同版本里
          // 可见性不一致，直接读会在编译期报错，这里自己记一份最稳。
          static bool amp_on = false;
          const bool busy = id(spk_out).is_running();
          if (busy) {
            id(amp_idle_ms) = 0;
            if (!amp_on) {
              id(amp_sd).turn_on();
              amp_on = true;
            }
          } else if (amp_on) {
            if (id(amp_idle_ms) == 0) {
              id(amp_idle_ms) = millis();
            } else if (millis() - id(amp_idle_ms) > 3000) {
              id(amp_sd).turn_off();
              amp_on = false;
              id(amp_idle_ms) = 0;
            }
          }

debug:
  id: dbg_comp
  update_interval: 10s      # 数据刷新周期（loop_time / free 共用）

# ==========================================================
# HA 数据源
# ==========================================================
# ==========================================================
# 外网数据通道：MQTT 单主题 + 本地结构体缓存
# ----------------------------------------------------------
# 数据流：
#   HA 自动化(每5s) → mqtt publish home/ha-monitor-display (retain)
#     → 本机 on_json_message 解析 → ha_data 结构体
#       → 各 template 传感器(1s 刷新) → 页面 lambda 读取
#
# 注意：结构体字段名与 JSON key 必须一一对应，
#       改字段时同步改 ha/monitor_display_push.yaml
# ==========================================================
# 平铺 globals：每个 HA 字段一个独立全局变量
# ----------------------------------------------------------
# 约定：id 命名 = ha_ + JSON 字段名，一一对应，
#      改字段时同步改 ha/monitor_display_push.yaml。
globals:
  # 功放静默计时（ms）：0 = 未开始计时。
  #   播放结束后等 3 秒再关 SD，避免连续两条播报之间反复开关功放（会有咔哒声）
  - id: amp_idle_ms
    type: uint32_t
    restore_value: false
    initial_value: '0'
  - id: hd_ts
    type: uint32_t
    restore_value: false
    initial_value: '0'
  - id: hd_fan1_rpm
    type: float
    restore_value: false
    initial_value: 'NAN'
  - id: hd_fan2_rpm
    type: float
    restore_value: false
    initial_value: 'NAN'
  - id: hd_fan1_speed
    type: float
    restore_value: false
    initial_value: 'NAN'
  - id: hd_fan2_speed
    type: float
    restore_value: false
    initial_value: 'NAN'
  - id: hd_temp_front
    type: float
    restore_value: false
    initial_value: 'NAN'
  - id: hd_temp_back
    type: float
    restore_value: false
    initial_value: 'NAN'
  - id: hd_temp_in
    type: float
    restore_value: false
    initial_value: 'NAN'
  - id: hd_temp_out
    type: float
    restore_value: false
    initial_value: 'NAN'
  - id: hd_family_home
    type: float
    restore_value: false
    initial_value: 'NAN'
  - id: hd_guest_visit
    type: float
    restore_value: false
    initial_value: 'NAN'
  - id: hd_phone_online
    type: float
    restore_value: false
    initial_value: 'NAN'
  - id: hd_server_count
    type: float
    restore_value: false
    initial_value: 'NAN'
  - id: hd_gateway_count
    type: float
    restore_value: false
    initial_value: 'NAN'
  - id: hd_ap_count
    type: float
    restore_value: false
    initial_value: 'NAN'
  - id: hd_monitor_count
    type: float
    restore_value: false
    initial_value: 'NAN'
  - id: hd_light_on
    type: float
    restore_value: false
    initial_value: 'NAN'
  - id: hd_curtain_closed
    type: float
    restore_value: false
    initial_value: 'NAN'
  - id: hd_climate_on
    type: float
    restore_value: false
    initial_value: 'NAN'
  - id: hd_equipment_on
    type: float
    restore_value: false
    initial_value: 'NAN'
  - id: hd_light_all
    type: float
    restore_value: false
    initial_value: 'NAN'
  - id: hd_curtain_all
    type: float
    restore_value: false
    initial_value: 'NAN'
  - id: hd_climate_all
    type: float
    restore_value: false
    initial_value: 'NAN'
  - id: hd_equipment_all
    type: float
    restore_value: false
    initial_value: 'NAN'
  - id: hd_weather_temp
    type: float
    restore_value: false
    initial_value: 'NAN'
  - id: hd_outdoor_temp
    type: float
    restore_value: false
    initial_value: 'NAN'
  - id: hd_energy_today
    type: float
    restore_value: false
    initial_value: 'NAN'
  - id: hd_gas_today
    type: float
    restore_value: false
    initial_value: 'NAN'
  # 车辆到家的距离（km）：轩逸 / 比亚迪
  - id: hd_xuanyi_dist
    type: float
    restore_value: false
    initial_value: 'NAN'
  - id: hd_byd_dist
    type: float
    restore_value: false
    initial_value: 'NAN'
  - id: hd_voltage
    type: float
    restore_value: false
    initial_value: 'NAN'
  - id: hd_water_pressure
    type: float
    restore_value: false
    initial_value: 'NAN'
  - id: hd_wan_uptime
    type: float
    restore_value: false
    initial_value: 'NAN'
  - id: hd_asr_count
    type: float
    restore_value: false
    initial_value: 'NAN'
  - id: hd_router_count
    type: float
    restore_value: false
    initial_value: 'NAN'
  - id: hd_device_ctrl
    type: float
    restore_value: false
    initial_value: 'NAN'
  - id: hd_terminal_count
    type: float
    restore_value: false
    initial_value: 'NAN'
  - id: hd_low_battery
    type: float
    restore_value: false
    initial_value: 'NAN'
  - id: hd_nas_cpu
    type: float
    restore_value: false
    initial_value: 'NAN'
  - id: hd_nas_mem
    type: float
    restore_value: false
    initial_value: 'NAN'
  - id: hd_screen_bright
    type: float
    restore_value: false
    initial_value: 'NAN'
  - id: hd_nas_download
    type: float
    restore_value: false
    initial_value: 'NAN'
  - id: hd_nas_upload
    type: float
    restore_value: false
    initial_value: 'NAN'
  - id: hd_device_a_online
    type: int8_t          # 三态：-1=无数据(null) 0=关 1=开
    restore_value: false
    initial_value: '-1'
  - id: hd_device_b_online
    type: int8_t          # 三态：-1=无数据(null) 0=关 1=开
    restore_value: false
    initial_value: '-1'
  - id: hd_device_a_name
    type: std::string     # 屏幕显示名（HA 下发，空则界面用「设备1」）
    restore_value: false
    initial_value: '""'
  - id: hd_device_b_name
    type: std::string     # 屏幕显示名（HA 下发，空则界面用「设备2」）
    restore_value: false
    initial_value: '""'
  - id: hd_wan_status
    type: int8_t          # 三态：-1=无数据(null) 0=关 1=开
    restore_value: false
    initial_value: '-1'
  - id: hd_voice_broadcast
    type: int8_t          # 三态：-1=无数据(null) 0=关 1=开
    restore_value: false
    initial_value: '-1'
  - id: hd_fan_in_switch
    type: int8_t          # 三态：-1=无数据(null) 0=关 1=开
    restore_value: false
    initial_value: '-1'
  - id: hd_fan_out_switch
    type: int8_t          # 三态：-1=无数据(null) 0=关 1=开
    restore_value: false
    initial_value: '-1'
  - id: hd_time_text
    type: std::string
    restore_value: false
    initial_value: '""'
  - id: hd_external_ip
    type: std::string
    restore_value: false
    initial_value: '""'
  - id: hd_weather
    type: std::string
    restore_value: false
    initial_value: '""'
  - id: hd_stock
    type: std::string
    restore_value: false
    initial_value: '""'
  - id: hd_stock_chg
    type: float
    restore_value: false
    initial_value: 'NAN'
  - id: hd_home_mode
    type: std::string
    restore_value: false
    initial_value: '""'
  - id: hd_activity_log
    type: std::string
    restore_value: false
    initial_value: '""'
  # 居家模式的音量百分比（sensor.ju_jia_mo_shi 的 volume_percent 属性，如 65）
  - id: hd_mode_volume
    type: float
    restore_value: false
    initial_value: 'NAN'
  - id: hd_parking_status
    type: std::string
    restore_value: false
    initial_value: '""'

  # 最近一次收到有效数据的时刻（millis，0 表示从未收到）
  - id: ha_data_last_ms
    type: uint32_t
    restore_value: false
    initial_value: "0"

  # 数据新鲜度阈值：超过该毫秒数没收到新帧就认为离线
  #   推送周期 5s，取 15s（3 个周期）作为容错窗口
  - id: ha_stale_ms
    type: uint32_t
    restore_value: false
    initial_value: "15000"

# ==========================================================
# 本机传感器（与 HA 无关，始终可用）
# ==========================================================
sensor:
  - platform: wifi_signal
    id: wifi_rssi
    name: "WiFi RSSI"
    icon: mdi:wifi
    update_interval: 15s
  - platform: uptime
    id: uptime_sensor
    icon: mdi:clock-start
    name: "Uptime"

  # loop_time / free 只能写在 platform: debug 下（由顶层 debug: 组件接管）
  - platform: debug
    loop_time:
      id: loop_time_sensor
      name: "Loop Time"
  - platform: debug
    free:
      id: free_heap_sensor
      name: "Free Heap"

  # ==========================================================
  # 以下为 MQTT 数据帧落地的 template 传感器
  # ==========================================================
  # fan1_rpm
  - platform: template
    id: ha_fan1_rpm
    internal: true
    update_interval: 1s
    lambda: |-
      if (id(ha_data_last_ms) == 0) return {};
      return id(hd_fan1_rpm);
  # fan2_rpm
  - platform: template
    id: ha_fan2_rpm
    internal: true
    update_interval: 1s
    lambda: |-
      if (id(ha_data_last_ms) == 0) return {};
      return id(hd_fan2_rpm);
  # fan1_speed
  - platform: template
    id: ha_fan1_speed
    internal: true
    update_interval: 1s
    lambda: |-
      if (id(ha_data_last_ms) == 0) return {};
      return id(hd_fan1_speed);
  # fan2_speed
  - platform: template
    id: ha_fan2_speed
    internal: true
    update_interval: 1s
    lambda: |-
      if (id(ha_data_last_ms) == 0) return {};
      return id(hd_fan2_speed);
  # temp_front
  - platform: template
    id: ha_temp_front
    internal: true
    update_interval: 1s
    lambda: |-
      if (id(ha_data_last_ms) == 0) return {};
      return id(hd_temp_front);
  # temp_back
  - platform: template
    id: ha_temp_back
    internal: true
    update_interval: 1s
    lambda: |-
      if (id(ha_data_last_ms) == 0) return {};
      return id(hd_temp_back);
  # temp_in
  - platform: template
    id: ha_temp_in
    internal: true
    update_interval: 1s
    lambda: |-
      if (id(ha_data_last_ms) == 0) return {};
      return id(hd_temp_in);
  # temp_out
  - platform: template
    id: ha_temp_out
    internal: true
    update_interval: 1s
    lambda: |-
      if (id(ha_data_last_ms) == 0) return {};
      return id(hd_temp_out);
  # family_home
  - platform: template
    id: ha_family_home
    internal: true
    update_interval: 1s
    lambda: |-
      if (id(ha_data_last_ms) == 0) return {};
      return id(hd_family_home);
  # guest_visit
  - platform: template
    id: ha_guest_visit
    internal: true
    update_interval: 1s
    lambda: |-
      if (id(ha_data_last_ms) == 0) return {};
      return id(hd_guest_visit);
  # phone_online
  - platform: template
    id: ha_phone_online
    internal: true
    update_interval: 1s
    lambda: |-
      if (id(ha_data_last_ms) == 0) return {};
      return id(hd_phone_online);
  # server_count
  - platform: template
    id: ha_server_count
    internal: true
    update_interval: 1s
    lambda: |-
      if (id(ha_data_last_ms) == 0) return {};
      return id(hd_server_count);
  # gateway_count
  - platform: template
    id: ha_gateway_count
    internal: true
    update_interval: 1s
    lambda: |-
      if (id(ha_data_last_ms) == 0) return {};
      return id(hd_gateway_count);
  # ap_count
  - platform: template
    id: ha_ap_count
    internal: true
    update_interval: 1s
    lambda: |-
      if (id(ha_data_last_ms) == 0) return {};
      return id(hd_ap_count);
  # monitor_count
  - platform: template
    id: ha_monitor_count
    internal: true
    update_interval: 1s
    lambda: |-
      if (id(ha_data_last_ms) == 0) return {};
      return id(hd_monitor_count);
  # light_on
  - platform: template
    id: ha_light_on
    internal: true
    update_interval: 1s
    lambda: |-
      if (id(ha_data_last_ms) == 0) return {};
      return id(hd_light_on);
  # curtain_closed
  - platform: template
    id: ha_curtain_closed
    internal: true
    update_interval: 1s
    lambda: |-
      if (id(ha_data_last_ms) == 0) return {};
      return id(hd_curtain_closed);
  # climate_on
  - platform: template
    id: ha_climate_on
    internal: true
    update_interval: 1s
    lambda: |-
      if (id(ha_data_last_ms) == 0) return {};
      return id(hd_climate_on);
  # equipment_on
  - platform: template
    id: ha_equipment_on
    internal: true
    update_interval: 1s
    lambda: |-
      if (id(ha_data_last_ms) == 0) return {};
      return id(hd_equipment_on);
  # weather_temp
  - platform: template
    id: ha_weather_temperature
    internal: true
    update_interval: 1s
    lambda: |-
      if (id(ha_data_last_ms) == 0) return {};
      return id(hd_weather_temp);
  # outdoor_temp
  - platform: template
    id: outdoor_temperature
    internal: true
    update_interval: 1s
    lambda: |-
      if (id(ha_data_last_ms) == 0) return {};
      return id(hd_outdoor_temp);
  # energy_today
  - platform: template
    id: ha_energy_today
    internal: true
    update_interval: 1s
    lambda: |-
      if (id(ha_data_last_ms) == 0) return {};
      return id(hd_energy_today);
  # gas_today
  - platform: template
    id: ha_gas_today
    internal: true
    update_interval: 1s
    lambda: |-
      if (id(ha_data_last_ms) == 0) return {};
      return id(hd_gas_today);
  # xuanyi_dist（轩逸距离 km）
  - platform: template
    id: ha_xuanyi_dist
    internal: true
    update_interval: 1s
    lambda: |-
      if (id(ha_data_last_ms) == 0) return {};
      return id(hd_xuanyi_dist);
  # byd_dist（比亚迪距离 km）
  - platform: template
    id: ha_byd_dist
    internal: true
    update_interval: 1s
    lambda: |-
      if (id(ha_data_last_ms) == 0) return {};
      return id(hd_byd_dist);
  # mode_volume（居家模式音量百分比，如 65）
  - platform: template
    id: ha_mode_volume
    internal: true
    update_interval: 1s
    lambda: |-
      if (id(ha_data_last_ms) == 0) return {};
      return id(hd_mode_volume);
  # voltage
  - platform: template
    id: ha_voltage
    internal: true
    update_interval: 1s
    lambda: |-
      if (id(ha_data_last_ms) == 0) return {};
      return id(hd_voltage);
  # water_pressure
  - platform: template
    id: ha_water_pressure
    internal: true
    update_interval: 1s
    lambda: |-
      if (id(ha_data_last_ms) == 0) return {};
      return id(hd_water_pressure);
  # wan_uptime
  - platform: template
    id: net_wan_uptime
    internal: true
    update_interval: 1s
    lambda: |-
      if (id(ha_data_last_ms) == 0) return {};
      return id(hd_wan_uptime);
  # asr_count
  - platform: template
    id: ha_asr_count
    internal: true
    update_interval: 1s
    lambda: |-
      if (id(ha_data_last_ms) == 0) return {};
      return id(hd_asr_count);
  # router_count
  - platform: template
    id: ha_router_count
    internal: true
    update_interval: 1s
    lambda: |-
      if (id(ha_data_last_ms) == 0) return {};
      return id(hd_router_count);
  # device_ctrl
  - platform: template
    id: ha_device_ctrl
    internal: true
    update_interval: 1s
    lambda: |-
      if (id(ha_data_last_ms) == 0) return {};
      return id(hd_device_ctrl);
  # terminal_count
  - platform: template
    id: ha_terminal_count
    internal: true
    update_interval: 1s
    lambda: |-
      if (id(ha_data_last_ms) == 0) return {};
      return id(hd_terminal_count);
  # low_battery
  - platform: template
    id: ha_low_battery
    internal: true
    update_interval: 1s
    lambda: |-
      if (id(ha_data_last_ms) == 0) return {};
      return id(hd_low_battery);
  # nas_cpu
  - platform: template
    id: ha_nas_cpu
    internal: true
    update_interval: 1s
    lambda: |-
      if (id(ha_data_last_ms) == 0) return {};
      return id(hd_nas_cpu);
  # nas_mem
  - platform: template
    id: ha_nas_mem
    internal: true
    update_interval: 1s
    lambda: |-
      if (id(ha_data_last_ms) == 0) return {};
      return id(hd_nas_mem);
  # screen_bright
  - platform: template
    id: ha_screen_brightness
    internal: true
    update_interval: 1s
    lambda: |-
      if (id(ha_data_last_ms) == 0) return {};
      return id(hd_screen_bright);
  # nas_download
  - platform: template
    id: ha_nas_download
    internal: true
    update_interval: 1s
    lambda: |-
      if (id(ha_data_last_ms) == 0) return {};
      return id(hd_nas_download);
  # nas_upload
  - platform: template
    id: ha_nas_upload
    internal: true
    update_interval: 1s
    lambda: |-
      if (id(ha_data_last_ms) == 0) return {};
      return id(hd_nas_upload);
  # stock_chg（上证涨跌幅：>0 涨红 / <0 跌绿 / =0 平白 / NAN 无数据灰）
  # 注意：必须是 float 传感器（放在 sensor: 段），text_sensor 返回 std::string，
  #       页面要的是数值比较，放错段会编译报 could not convert 'float' 错误。
  - platform: template
    id: ha_stock_chg
    internal: true
    update_interval: 1s
    lambda: |-
      if (id(ha_data_last_ms) == 0) return {};
      return id(hd_stock_chg);

number:
  # 熄屏超时（秒），默认 60s，HA 可调，重启后保留
  - platform: template
    id: sleep_timeout_number
    name: "Sleep Timeout"
    icon: mdi:timer-outline
    entity_category: config
    unit_of_measurement: "s"
    mode: box
    min_value: 15
    max_value: 900
    step: 5
    optimistic: true
    restore_value: true
    initial_value: 60

  # 屏幕亮度滑块（%，v1.1.1）。唯一数据源 = 本机灯实体 lcd_backlight：
  #   显示值 lambda 轮询灯实体当前亮度（在 HA 里直接调 light 实体，滑块 2s 内跟随）；
  #   set_action 把滑块值写回灯实体，同时更新熄屏恢复用的 ui_saved_brightness。
  #   熄屏期间滑块显示空值，防止误触把屏点亮；最低 10% 防止调到看不见。
  - platform: template
    id: screen_brightness_number
    name: "Screen Brightness"
    icon: mdi:brightness-percent
    entity_category: config
    unit_of_measurement: "%"
    mode: slider
    min_value: 10
    max_value: 100
    step: 5
    update_interval: 2s
    lambda: |-
      if (id(ui_screen_off)) return {};
      return id(lcd_backlight).remote_values.get_brightness() * 100.0f;
    set_action:
      - lambda: |-
          const float b = x / 100.0f;
          id(ui_saved_brightness) = b;
          if (!id(ui_screen_off)) {
            auto call = id(lcd_backlight).turn_on();
            call.set_brightness(b);
            call.perform();
          }

select:
  # ----------------------------------------------------------
  # 每页卡片底色（HA 下拉选色，v1.1.0）
  #   只提供深色系：白字与橙紫绿蓝图标要在底色上读得清。
  #   固件侧保留每通道 0xFE 的防误填钳制（八轮起放开，图色可原样上屏）。
  #   选中即重绘（无需重启）；断电重启由 restore_value 恢复上次选择。
  #   缝隙色（四周边距/卡间）不单独暴露，由选色自动压暗到 50%。
  #   八档（10-31 十二轮定版）：石墨（默认）/ 深红 831C0C / 深黄 866603 /
  #     墨绿 0E3A20 / 浅蓝 017989 / 深蓝 14285A / 深紫 32174D / 深靛 241A48
  #   （深红 = 六轮 5A1818 与十轮 AD2001 的逐通道中间值，白字对比约 9.1:1；
  #     橙色 866603 只改名"深黄"色值不动；深靛 241A48 为五轮三档旧值新增）
  #   注：六色相档下灰 757575 对底色只有 1.3~2.2:1，灰状态字（断开/无数据）
  #       会明显偏弱 —— 已与用户确认可接受，优先色相表现。
  # ----------------------------------------------------------
  - platform: template
    id: sel_bg_dash
    name: "Dashboard Bg Color"
    icon: mdi:palette
    entity_category: config
    optimistic: true
    restore_value: true
    initial_option: "石墨 1E1E1E"
    options:
      - "石墨 1E1E1E"
      - "深红 831C0C"
      - "深黄 866603"
      - "墨绿 0E3A20"
      - "浅蓝 017989"
      - "深蓝 14285A"
      - "深紫 32174D"
      - "深靛 241A48"
    on_value:
      - lambda: |-
          // 选项形如“深蓝 13223B”，取末尾 6 位十六进制即色值
          if (x.size() < 6) return;
          id(ui_bg_dash) = (uint32_t) strtoul(x.c_str() + x.size() - 6, nullptr, 16);
      - script.execute:
          id: ui_apply_bg
          page: 0
      # 通知页共用家居底色（v2.0），同时跟随
      - script.execute:
          id: ui_apply_bg
          page: 3

  - platform: template
    id: sel_bg_net
    name: "Network Bg Color"
    icon: mdi:palette
    entity_category: config
    optimistic: true
    restore_value: true
    initial_option: "石墨 1E1E1E"
    options:
      - "石墨 1E1E1E"
      - "深红 831C0C"
      - "深黄 866603"
      - "墨绿 0E3A20"
      - "浅蓝 017989"
      - "深蓝 14285A"
      - "深紫 32174D"
      - "深靛 241A48"
    on_value:
      - lambda: |-
          if (x.size() < 6) return;
          id(ui_bg_net) = (uint32_t) strtoul(x.c_str() + x.size() - 6, nullptr, 16);
      - script.execute:
          id: ui_apply_bg
          page: 1

  - platform: template
    id: sel_bg_sys
    name: "System Bg Color"
    icon: mdi:palette
    entity_category: config
    optimistic: true
    restore_value: true
    initial_option: "石墨 1E1E1E"
    options:
      - "石墨 1E1E1E"
      - "深红 831C0C"
      - "深黄 866603"
      - "墨绿 0E3A20"
      - "浅蓝 017989"
      - "深蓝 14285A"
      - "深紫 32174D"
      - "深靛 241A48"
    on_value:
      - lambda: |-
          if (x.size() < 6) return;
          id(ui_bg_sys) = (uint32_t) strtoul(x.c_str() + x.size() - 6, nullptr, 16);
      - script.execute:
          id: ui_apply_bg
          page: 2

switch:
  # 功放使能（MAX98357A SD 脚）——内部实体，不暴露给 HA
  #   拉低 = 功放彻底关断（待机 <1µA）；由下面 interval 的音频监控自动管理
  - platform: gpio
    id: amp_sd
    internal: true
    pin: GPIO21
    restore_mode: ALWAYS_OFF

  # 自动休眠总开关（关掉后常亮，适合调试/演示）
  - platform: template
    id: auto_sleep_switch
    name: "Auto Screen Sleep"
    icon: mdi:sleep
    entity_category: config
    optimistic: true
    restore_mode: RESTORE_DEFAULT_ON
    lambda: |-
      return id(ui_auto_sleep_enabled);
    turn_on_action:
      - lambda: id(ui_auto_sleep_enabled) = true;
    turn_off_action:
      - lambda: id(ui_auto_sleep_enabled) = false;
      # 关闭自动休眠时顺便点亮，避免停在黑屏状态
      - script.execute: wake_screen

  # 通知亮屏开关（v2.0 NOTIFY）
  #   默认关：一次推送就唤醒屏幕，20mA 待机会瞬间回到 150mA+ 的亮屏功耗。
  #   打开后，收到通知且屏幕处于熄屏态时才点亮；亮屏中收到通知不受影响。
  - platform: template
    id: notify_wake_on_msg
    name: "Notify Wake Screen"
    icon: mdi:bell-ring
    entity_category: config
    optimistic: true
    restore_mode: RESTORE_DEFAULT_OFF

script:
  # ----------------------------------------------------------
  # 应用页面背景配色（v1.1.0）
  #   卡片底色 = HA 下拉选定色；四周 5px 边距 + 卡间 3px 缝隙 = 选定色 × 0.5
  #   一轮用 0.6 倍 + 每通道 0x40 钳制，实测切换档位几乎看不出差别；
  #   二轮（10-31）参考 HA iOS 深色主题色阶重做：
  #     - 缝隙系数 0.6 → 0.5，拉开卡片与底色的边界对比
  #     - 钳制上限 0x40 → 0x50，色相通道不再被压低
  #     - 8 档色值整体提饱和（石墨沿用 1E1E1E，默认观感不变）
  #   三轮（10-31）色板试过壁纸取色的 7 色，一度收敛为 3 档
  #   四轮（10-31）按用户要求放到 7 档；九轮（13:16）橙/浅蓝/深红改用用户提供的图色，
  #     钳制上限 0xB4→0xFE（图色 FE 顶原样上屏）；
  #   五轮（10-31）用户反馈偏亮，六档色相统一 ×0.75 压暗（石墨默认档不动）：
  #     石墨 1E1E1E / 深红 5A1818 / 墨绿 0E3A20 / 深蓝 14285A / 深紫 32174D；
  #     九轮：橙/浅蓝/深红用用户图色原样上屏（FEE677/01CFE2/FE7A58），
  #           白字对比 1.25/1.90/2.58 实测不可读，用户确认废弃；
  #     十轮：保图色色相压明度——橙色 866603（h45，白5.36）/ 浅蓝 017989（h187，白5.13）/ 深红 AD2001（h11，白7.04）
  #   十一轮：橙色 866603 改名"深黄"（色值不动）；新增深靛 241A48（五轮三档旧值，与深紫区分）；
  #   十二轮：深红偏暗，取六轮 5A1818 与十轮 AD2001 中间值 831C0C（白字对比 9.1:1），共八档
  #   page: 0=家居  1=网络  2=系统
  # ----------------------------------------------------------
  - id: ui_apply_bg
    mode: restart
    parameters:
      page: int
    then:
      - lambda: |-
          if (!id(lvgl_ready)) return;

          // 注意：page 对象是 LvPageType*，底层 lv_obj_t* 在 ->obj 成员里
          //   page: 0=家居 1=网络 2=系统 3=通知（v2.0，共用家居底色）
          lv_obj_t* scr = (page == 0) ? id(dashboard_page)->obj
                        : ((page == 1) ? id(network_page)->obj
                        : ((page == 2) ? id(system_page)->obj : id(notify_page)->obj));
          if (scr == nullptr) return;

          uint32_t c = (page == 0 || page == 3) ? id(ui_bg_dash)
                     : ((page == 1) ? id(ui_bg_net) : id(ui_bg_sys));

          // 亮度钳制（每通道 ≤ 0xFE）：只防纯白误填，不压色相（九轮放开）
          uint32_t r = (c >> 16) & 0xFF;
          uint32_t g = (c >> 8) & 0xFF;
          uint32_t b = c & 0xFF;
          if (r > 0xFE) r = 0xFE;
          if (g > 0xFE) g = 0xFE;
          if (b > 0xFE) b = 0xFE;
          const uint32_t card = (r << 16) | (g << 8) | b;

          // 缝隙/边距：同色压暗到 50%（拉出卡片轮廓）
          const uint32_t gap = ((r * 5 / 10) << 16) | ((g * 5 / 10) << 8) | (b * 5 / 10);
          lv_obj_set_style_bg_color(scr, lv_color_hex(gap), 0);

          // 所有顶层容器（各卡片 + TAB 导航栏）统一底色；跳过 5px 以下的装饰线
          const uint32_t n = lv_obj_get_child_count(scr);
          for (uint32_t i = 0; i < n; i++) {
            lv_obj_t* ch = lv_obj_get_child(scr, i);
            if (ch == nullptr) continue;
            if (lv_obj_get_height(ch) <= 5) continue;
            lv_obj_set_style_bg_color(ch, lv_color_hex(card), 0);
          }

  # 熄屏：先记住当前亮度，再关背光
  - id: sleep_screen
    mode: single
    then:
      - lambda: |-
          float b = id(lcd_backlight).remote_values.get_brightness();
          if (b <= 0.01f) b = 1.0f;   // 已接近 0 时按满亮度恢复，防锁死
          id(ui_saved_brightness) = b;
          id(ui_screen_off) = true;
          ESP_LOGI("sleep", "screen off, saved brightness=%.2f", b);
      - light.turn_off: lcd_backlight

  # 唤醒：恢复熄屏前的亮度（不是写死 100%）
  - id: wake_screen
    mode: single
    then:
      - lambda: |-
          // 唤醒后设保持期（默认 15s，熄屏超时更短则按更短的来）。
          //   亮屏不产生触摸输入，LVGL 的「无输入时间」不会归零，
          //   若它已超过阈值，1s 巡检会当场把屏关回去（通知闪一下就灭）。
          uint32_t hold = 15000;
          const uint32_t tmo = (uint32_t) (id(sleep_timeout_number).state * 1000.0f);
          if (tmo > 0 && tmo < hold) hold = tmo;
          id(ui_hold_until) = millis() + hold;
          id(ui_screen_off) = false;
      - light.turn_on:
          id: lcd_backlight
          brightness: !lambda |-
            return id(ui_saved_brightness);
      - logger.log: "screen on"

  # ----------------------------------------------------------
  # MQTT 状态回发（v2.1 远程控制通道）
  #   5 个受控量的当前值拼成一帧 JSON，retain 发到
  #   esphome/ha-monitor-display/state，HA 侧 mqtt 实体据此显示。
  #   light = 屏幕是否点亮（!ui_screen_off）。
  #   bright 取 ui_saved_brightness（熄屏时滑块实体返回空值，不能拿它）。
  # ----------------------------------------------------------
  - id: mqtt_pub_state
    mode: restart
    then:
      - mqtt.publish:
          topic: esphome/ha-monitor-display/state
          retain: true
          payload: !lambda |-
            char buf[192];
            snprintf(buf, sizeof(buf),
                     "{\"light\":%s,\"bright\":%d,\"sleep\":%d,"
                     "\"autosleep\":%s,\"wake\":%s}",
                     id(ui_screen_off) ? "false" : "true",
                     (int) (id(ui_saved_brightness) * 100.0f + 0.5f),
                     (int) id(sleep_timeout_number).state,
                     id(ui_auto_sleep_enabled) ? "true" : "false",
                     id(notify_wake_on_msg).state ? "true" : "false");
            return std::string(buf);

# ==========================================================
# 开关类实体（MQTT 数据帧落地）
# ----------------------------------------------------------
# 说明：TemplateBinarySensor 的 loop() 每轮都会调用 lambda 并
# publish_state()，本身就会实时刷新，无需 update_interval
# （该选项在 binary_sensor.template 上并不存在）。
# 但 loop() 在 MQTT 首帧到达前就会发布初始值，所以这里加
# ha_data_last_ms == 0 守卫，避免开机瞬间把 "--" 误判成"关"。
# ==========================================================
binary_sensor:
  # device_a_online（通用槽位：任意 binary_sensor，名称由 HA 下发）
  - platform: template
    id: ha_device_a_online
    internal: true
    lambda: |-
      // 三态：-1 表示 HA 侧实体不存在/无数据，此时不发布（保持 has_state=false）
      if (id(ha_data_last_ms) == 0 || id(hd_device_a_online) < 0) return {};
      return id(hd_device_a_online) != 0;
  # device_b_online
  - platform: template
    id: ha_device_b_online
    internal: true
    lambda: |-
      // 三态：-1 表示 HA 侧实体不存在/无数据，此时不发布（保持 has_state=false）
      if (id(ha_data_last_ms) == 0 || id(hd_device_b_online) < 0) return {};
      return id(hd_device_b_online) != 0;
  # wan_status
  - platform: template
    id: net_wan_status
    internal: true
    lambda: |-
      // 三态：-1 表示 HA 侧实体不存在/无数据，此时不发布（保持 has_state=false）
      if (id(ha_data_last_ms) == 0 || id(hd_wan_status) < 0) return {};
      return id(hd_wan_status) != 0;
  # voice_broadcast
  - platform: template
    id: ha_voice_broadcast
    internal: true
    lambda: |-
      // 三态：-1 表示 HA 侧实体不存在/无数据，此时不发布（保持 has_state=false）
      if (id(ha_data_last_ms) == 0 || id(hd_voice_broadcast) < 0) return {};
      return id(hd_voice_broadcast) != 0;
  # fan_in_switch
  - platform: template
    id: ha_fan_in_switch
    internal: true
    lambda: |-
      // 三态：-1 表示 HA 侧实体不存在/无数据，此时不发布（保持 has_state=false）
      if (id(ha_data_last_ms) == 0 || id(hd_fan_in_switch) < 0) return {};
      return id(hd_fan_in_switch) != 0;
  # fan_out_switch
  - platform: template
    id: ha_fan_out_switch
    internal: true
    lambda: |-
      // 三态：-1 表示 HA 侧实体不存在/无数据，此时不发布（保持 has_state=false）
      if (id(ha_data_last_ms) == 0 || id(hd_fan_out_switch) < 0) return {};
      return id(hd_fan_out_switch) != 0;

# ==========================================================
# 本机网络信息 + MQTT 文本数据
# ==========================================================
text_sensor:
  - platform: wifi_info
    ip_address:
      id: wifi_ip_address
      name: "IP Address"
      icon: mdi:ip-network
    ssid:
      id: wifi_ssid_sensor
      name: "WiFi SSID"
      icon: mdi:router-wireless
    mac_address:
      id: wifi_mac_sensor
      name: "MAC Address"
      icon: mdi:wifi-marker
  - platform: wifi_info
    bssid:
      id: wifi_bssid_sensor
      name: "WiFi BSSID"
      icon: mdi:access-point-network

  # ==========================================================
  # 以下为 MQTT 数据帧落地的 template 文本传感器
  # ==========================================================
  # time_text
  - platform: template
    id: ha_time_text
    internal: true
    update_interval: 1s
    lambda: |-
      if (id(ha_data_last_ms) == 0) return {};
      return { id(hd_time_text) };
  # external_ip
  - platform: template
    id: net_external_ip
    internal: true
    update_interval: 1s
    lambda: |-
      if (id(ha_data_last_ms) == 0) return {};
      return { id(hd_external_ip) };
  # weather
  - platform: template
    id: ha_weather
    internal: true
    update_interval: 1s
    lambda: |-
      if (id(ha_data_last_ms) == 0) return {};
      return { id(hd_weather) };
  # stock
  - platform: template
    id: ha_stock
    internal: true
    update_interval: 1s
    lambda: |-
      if (id(ha_data_last_ms) == 0) return {};
      return { id(hd_stock) };
  # home_mode
  - platform: template
    id: ha_home_mode
    internal: true
    update_interval: 1s
    lambda: |-
      if (id(ha_data_last_ms) == 0) return {};
      return { id(hd_home_mode) };
  # activity_log
  - platform: template
    id: ha_activity_log
    internal: true
    update_interval: 1s
    lambda: |-
      if (id(ha_data_last_ms) == 0) return {};
      return { id(hd_activity_log) };
  # parking_status
  - platform: template
    id: ha_parking_status
    internal: true
    update_interval: 1s
    lambda: |-
      if (id(ha_data_last_ms) == 0) return {};
      return { id(hd_parking_status) };
