lambilly/ha-monitor-display/(commit log)

2026-10-30 v1.0: 硬件与外壳阶段的冻结基线
    三页 LVGL 界面（家庭 / 网络 / 系统）+ MQTT 数据通道 + 自动休眠，
    配色第三轮修正已合入。功能到此冻结：本线只接受参数微调（发 v1.0.x），
    新增功能一律进 v2.0。
    本版包含
    - ha-monitor-display.yaml 主配置：esp32-s3 / wifi / mqtt / spi / 屏 / 触摸 / 休眠
    - ui_common.yaml 字体（白名单字形）、globals、公共控件
    - page_dashboard.yaml 家庭页：电器、能耗、天气、居家模式、车位
    - page_network.yaml 网络页：总览、NAS、四路风扇、低电量
    - page_system.yaml 系统页：三列指标、网络参数、SSID/IP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
    [ha-monitor-display.yaml, page_dashboard.yaml, page_network.yaml, page_notify.yaml, page_system.yaml]
2026-10-30 v1.0 优化：区块标题加图标 + 三处文案改名 + 活动轨迹补字
    图标（8 个区块标题，16px MDI，白色，height:18 与 12px 标题文字中线对齐）
    - 电器动态 devices / 今日能耗 chart-line / 网络运行 access-point-network
    - NAS运行 nas / 风扇运行 fan / 设备信息 information-outline
    - 系统负载 gauge / 网络参数 tune
    标题文字由 x=8 右移到 x=25（NAS 列 20 / 风扇列 19），与下方四行图标-文字列对齐。
    文案
    - 概览 → 家居（三页 TAB 导航）
    - 网络总览 → 网络运行
    - NAS状态 → NAS运行
    字库
    - 活动轨迹补 19 字：茶生走影帽智库庭院藏过娱健身阅办宠乐角
    （茶桌原缺"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
2026-10-30 v1.0 微调：8 个区块标题图标整体下移 1px
    真机验证反馈：图标与标题文字基线不符，图标偏高 1px。
    家居页 电器动态/今日能耗 y -42 → -41
    网络页 网络运行/NAS运行/风扇运行 y -60 → -59
    系统页 设备信息/系统负载/网络参数 y -60 → -59
    标题文字位置不变，仅图标下移。
2026-10-30 v1.0 微调：电器动态/NAS运行图标再下移 1px + 今日能耗换图标
    - 电器动态 y -41 → -40（devices 图标重心偏上）
    - NAS运行 y -59 → -58（nas 图标重心偏上）
    - 今日能耗 chart-line(F012A) → chart-bar(F012C)
    chart-line 已用于顶部"上证"行情，两者重复；改为柱状图表示能耗统计，
    与上证的折线走势形成语义区分。白名单补 F012C（52 图标零重复）。
2026-10-31 配色第二轮：全局色彩规划落地 + 上证涨跌动态着色
    新色彩规则：橙紫绿蓝=固定字色；红灰黄=动态字色；白青=灵活补充+大标题
    家居页
    - 居家模式：在家橙/离家红/休息紫/影音黄，图标+文字同步，无数据全白
    - 车位状态：空闲绿/比亚迪粉 FF80AB/轩逸黄，其他与无数据回落白色
    - 行2：手机 >0 蓝（原绿）；语音 开绿关红（原开蓝）
    - 上证：接入 sensor.mei_ri_gu_zhi 属性 Sh000001.changeRatio 涨跌着色
    涨红/跌绿/平白/无数据灰，图标+前缀+数值三件套同步
    （主配置新增 hd_stock_chg global + ha_stock_chg sensor，
    推送 automation 新增 stock_chg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
2026-10-31 修复编译失败：ha_stock_chg 误放 text_sensor 段
    ha_stock（上证点位）是文本传感器，新增的 ha_stock_chg（涨跌幅）紧挨着
    写在它下面，结果落进了 text_sensor: 段，模板 lambda 返回 float 而
    text_sensor 期望 optional<std::string>，编译报：
    could not convert 'float' to 'std::optional<std::string>'
    cannot convert 'std::string' to 'const float'
    修复：把 ha_stock_chg 移到 sensor: 段（float 传感器），text_sensor 段
    只保留 ha_stock。hd_stock_chg 全局变量（float / NAN 初值）不变。
    [ha-monitor-display.yaml]
2026-10-31 web_server: 认证改为 digest
    消除 ESPHome 警告：auth 默认 basic 会以 Base64 发送密码（等同明文），
    2027.1.0 起默认值将改为 digest。现在显式写 type: digest 提前对齐，
    浏览器登录方式不变；REST 客户端需改用 curl --digest。
2026-10-31 修复 stock_chg 恒为 null：属性键名大小写不符
    sensor.mei_ri_gu_zhi 的属性键实际是 sh000001（全小写），推送里写成了
    Sh000001，state_attr 取不到 → .get() 返回 None → 屏幕上证永远显灰。
    改为模板头部先取属性（小写优先、大写兼容），再安全判 mapping 与
    changeRatio 键是否存在；任一不满足发 none。字段改用 ns.stock_chg。
    本地 Jinja2 渲染验证 6 种情况（跌/涨/大写键/属性缺失/非字典/无该键）
    全部符合预期，输出 51 字段 JSON 合法。
2026-10-31 修正今日能耗图标：F012C(check 对勾) → F0128(chart-bar 柱状图)
    上一轮把 chart-bar 的码点记错了一位，F012C 在字体里实际是 check，
    真机上显示成一个对勾。字体实测：chart-bar = U+F0128。
    同时核对本轮全部 8 个标题图标 + 上证图标共 9 个码点，逐个比对字体
    cmap 字形名，其余 8 个（devices / access-point-network / nas / fan /
    information-outline / gauge / tune / chart-line）均一致。
    白名单 52 码点零重复，页面 45 码点全部命中且字体已收录。
    [page_dashboard.yaml]
2026-10-31 NAS 未载入显灰 + 风扇开/≤50% 改黄 + 能耗图标下移 1px
    - 今日能耗图标 y -41 → -40（chart-bar 重心偏上手感一致于 devices/nas）
    - NAS CPU利用 / 内存可用 的 label 静态色改灰 757575，未载入数据时与
    上传/下载一样显灰 "--"；set_pct 兜底格式补空格（原 "CPU利用:--" →
    "CPU利用: --"，与全项目"名称: 值"约定一致）
    - 顺带修：net_nas_download_label 静态色仍是旧黄 FF D54F，与蓝色图标
    （0x5AA9FF）不一致，改为蓝
    - 风扇分档：开 / ≤50% 绿 59D98B → 黄 FFD54F（含"有转速无百分比"的
    "%d转"分支、进/出扇的"开"）；51~80% 橙、>80% 红保持不变
2026-10-31 修正：NAS CPU/内存未载入时用基色而非灰色
    上一轮理解偏差：上传/下载的兜底其实是"无数据仍保持本行基色"，
    不是灰色。CPU/内存改回同样规则：
    - net_nas_cpu_label 静态色 757575 → FF B74D（橙，与图标一致）
    - net_nas_mem_label 静态色 757575 → B39DFF（紫，与图标一致）
    - set_pct 无数据分支 0x757575 → base_color 参数
    格式仍为 "CPU利用: --"（半角冒号 + 空格）。告警分档黄/红不变。
    [page_network.yaml]
2026-10-31 v1.1.0 新增：每页背景色 HA 下拉可调（深色系预设）
    三页各一个 select 实体（Dashboard / Network / System Bg Color），
    8 个深色预设施加即时生效，断电重启由 restore_value 恢复。
    配色范围（"间隙 vs 卡片"）
    - 卡片底色 = 选定色（覆盖 screen 全部顶层容器，含 TAB 导航栏）
    - 四周 5px 边距 + 卡间 3px 缝隙 = 选定色 × 0.6
    0.6 倍即现有关系（1E1E1E 卡片 / 121212 缝隙），选"默认深灰"零变化
    实现
    - ui_common globals: ui_bg_dash / ui_bg_net / ui_bg_sys（uint32_t，restore）
    - 主配置 script ui_apply_bg(page)：读 global → 每通道 0x40 上限钳制 →
    遍历 screen 顶层 child 统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
2026-10-31 README: 补记 v1.0.1 定版与 v1.1.0 待验证状态
2026-10-31 v1.1.0: 主配置头部加版本标记，便于真机目录辨识备份版本
2026-10-31 修复编译错误：LvPageType* 取 ->obj 才能转 lv_obj_t*
    [ha-monitor-display.yaml]
2026-10-31 v1.1.0 背景色二轮：按 HA iOS 深色色阶重做 8 档，缝隙系数 0.6→0.5、钳制上限 0x40→0x50
2026-10-31 v1.1.0 背景色三轮：色相取自 HA iOS 主题 7 张 HomeKit 壁纸主色（PIL 实测提取）
2026-10-31 v1.1.0 背景色定版：8 档精简为 3 档（石墨 1E1E1E / 深空黑 101012 / 深靛 241A48）
2026-10-31 v1.1.0 白字改造：49 处静态文字色改白 + 7 处 lambda 基色改白；图标/灰/TAB青/上证动态色全保留；背景色加第四档 亮灰 3A3A3C
2026-10-31 注释同步：背景色四档描述
2026-10-31 v1.1.0 四轮：背景色放到 7 档大胆色相（钳制 0x50→0xB4）；8 个区块标题图标统一青 4FD8FA；天气图标青；网络页已连接改白
2026-10-31 v1.1.0 五轮：七档背景色整体压暗（六色相 ×0.75，石墨默认不动）；网络页已连接图标恢复绿 59D98B、文字保持白
2026-10-31 家居页行2：在家/客人/手机/语音 名称恒白、图标无数据时转白，数值保留动态色（改 recolor 内联着色）
2026-10-31 家居页行2：三格图标改回恒为规划基色（橙/紫/蓝），不再随数量=0 灰化；修正手机/语音图标静态初值互换
2026-10-31 v1.1.0 六轮：居家模式/车位状态图标间距-2px；两行文字全白、状态色移到图标；活动轨迹无活动显示灰 --；七档背景色再×0.75压暗
2026-10-31 语音格图标恒绿（与前三个一致）；暗橙 542E08→643408（按用户图2 橙色调重做，去棕感）
2026-10-31 新增 Screen Brightness 滑块实体（template number 双向同步本机灯实体）；系统页亮度显示改本机直读，摆脱 HA 推送 5s 延迟
2026-10-31 v1.1.0 八轮：暗橙 643408→亮橙 A06232、深青 08383F→亮青 0C7C8C（其余五档维持六轮值）
2026-10-31 v1.1.0 九轮：橙色 FEE677/浅蓝 01CFE2/深红 FE7A58 改用用户图色原样上屏；钳制 0xB4→0xFE
2026-10-31 v1.1.0 十轮：九轮图色原样上屏不可读，保色相压明度——橙色 866603/浅蓝 017989/深红 AD2001（白字 5.36/5.13/7.04）
2026-10-31 全局规则：-- 占位符一律灰 757575——静态初值 41 处改灰；lambda 补灰色分支（车位/设备计数/能耗/天气/外网IP/已连接/带单位计数/NAS/网速/温度/SSID/IP/内存/外存/循环/亮度/RSSI）；NAS 基色兜底改灰；WiFi/MQTT/SIGQ 前缀显式白
2026-10-31 修正 -- 灰规则过宽：名称恢复原色（白/基色），仅 -- 内联灰（recolor）；背景色十一轮：深红改回 5A1818、橙色改名深黄、新增深靛 241A48（共八档）
    [ha-monitor-display.yaml, page_dashboard.yaml, page_network.yaml, page_system.yaml]
2026-10-31 十二轮：居家模式四模式字与车位三状态字随图标同色（前缀/轨迹仍白）；深红取中间值 831C0C（白字 9.1:1）
2026-10-31 新增车辆距离：车位卡片下方两行 12px（轩逸黄 FFD54F / 比亚迪粉 FF80AB，单位 km）；推送 payload + hd_/ha_ 两级实体接入
2026-10-31 修复推送脚本：Jinja 表达式内的裸 # 注释导致语法报错，改为表达式外花括号注释
2026-10-31 车位卡改左右分栏：左侧图标+车位状态一行（恢复原位），右栏上下两行公里数（12px 黄/粉，右对齐，仅数值+km）
2026-10-31 车位卡微调：左列左移3px（图标x5/状态x29），右栏右移2px（x-6）、行距-2px（y -8/+8）
2026-10-31 十七轮：居家模式轨迹后附加 volume_percent（如 65%，无属性不显示）；居家模式左列左移 3px（x5/x29）与车位卡对齐；车位右栏右移至 3px
2026-10-31 系统页行1新增当前时间：24小时制 HH:MM，卡片居中白字 16px；SNTP 未同步时灰 --:--，1s interval 刷新
2026-10-31 修复编译错误：ha_mode_volume 误放在 text_sensor 段（被判成文本传感器），移到 sensor 段并改 return 不带花括号
    [ha-monitor-display.yaml]
2026-10-31 十九轮：车位卡左列-3px右列+2px；三页TAB家居-10px系统+10px；今日能耗改序为电压/水压/用气/用电（行位色黄紫蓝绿不变）；音量百分比数据链容错（HA 侧四候选属性名+去%，设备端兼容字符串数字+缺失告警）
2026-10-31 二十轮：居家模式65%移至轨迹前并随模式色；三页TAB家居-15/系统+15；系统页时间前加黄色时钟图标、运行组右移15px
2026-10-31 二十一轮：二三页行1左块（图标+文字）整体左移3px（图标x4→1、文字x26→23），首元素视觉左边界与第一页行1对齐
2026-10-31 release: v1.1.0 定版出包（背景色八档 / 车位距离分栏 / 居家模式音量 / 系统页时钟 / 白字统一），9 条目 MD5 校验一致；新增 scan_glyphs.py 缺字扫描脚本
2026-11-01 v1.1.1：续航优化——WiFi power_save_mode=light（待机省约1/3电流）；默认屏幕亮度60%（ui_saved_brightness 初值0.6 + lvgl on_boot 按 saved 值点亮），灯实体 ALWAYS_ON→ALWAYS_OFF 避免开机满亮闪变
2026-11-01 release: v1.1.1 定版出包（WiFi modem-sleep + 默认亮度60%），实测熄屏待机 20mA；本包作为 v2.0 开发前的回退基线，10 条目含 README
2026-11-01 docs: v2.0 NOTIFY 方案分析（数据链路四层 / 字库310KB账 / 4槽渲染改造点 / 入口三方案对比 / 风险8项 / 四阶段计划）
2026-11-01 v2.0 NOTIFY 首批：第四页通知（单条全屏+切换+滚动+删当前条）、GB2312 3755 字字库、MQTT notify 订阅与 8 槽环形缓冲、四键 TAB 抽成 ui/tab_bar.yaml 共用并按 ui_current_page 运行时高亮；旋转 90→270；NR 子流程 emoji 映射彩点、上限 460B→3400B
2026-11-01 fix: TAB 片段 include 路径改为同目录相对（!include 按包含文件所在目录解析，原 ui/tab_bar.yaml 被拼成 ui/ui/tab_bar.yaml）；通知页补 ‹›«»←→ 字形；新增 .workbuddy/check_includes.py 做 include/资源路径预检；scan_glyphs 增加非汉字符号缺字检查
    [page_dashboard.yaml, page_network.yaml, page_notify.yaml, page_system.yaml]
2026-11-01 fix: NotoSansSC 无 ✗(U+2717) 字形 → 改用 ×(U+00D7)，ui_common 字表与 NR 子流程同步替换；scan_glyphs 增加「声明字形 vs 字体 cmap」真伪校验，杜绝此类编译前漏检
2026-11-01 fix: notify 亮屏开关判断读 .state —— id(switch) 是对象指针永不为空，原写法让开关失效（-Waddress 警告已指出），实际效果是不管开关状态收通知都亮屏
    [ha-monitor-display.yaml]
2026-11-01 v2.0 通知页四项调整：① TAB 四键整体左移 20px；② 顶栏 h30→h50 对齐前三页、MDI 铃铛替代青竖条、相对时间改 10px 专用字体；③ 切换条加「全部删除」（notify_store 新增 clear_all）；④ 正文改仅纵向滚动 + 新增强制 WRAP + normalize 还原字面量换行 + 长文自动慢速下滚；另加设备端字形码表 notify_charset.h 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
2026-11-01 fix: ui_font_notify_time 字表「刚刚分钟前小时天」中「刚」重复声明 → 改为「刚分钟前小时天」（ESPHome 对同一字体重复码位是硬错误）；scan_glyphs 增加第 5 段字体内部重复字形校验
2026-11-01 fix: notify_charset.h 未登记进 esphome.includes → 构建目录 src/ui/ 下缺文件导致 fatal error；补登并给 check_includes.py 增加「嵌套 #include 依赖」检查（头文件里的引号包含必须同样登记）
    [ha-monitor-display.yaml]
2026-11-01 v2.0 通知页四项修正：① 铃铛 U+F009A 未进 &mdi_glyphs 导致标题图标方框 → 补入（三档共用）；② 正文换行失效根因是宽度被 LVGL 文本重算覆盖 → 每次渲染 set_text 后重设 width450+WRAP+update_layout，左右各留 10px、text_align LEFT；③ 切换条「删除」改橙 FFB74D 前置、「全部删除」改红 FF5252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
    [page_notify.yaml]
2026-11-01 v2.0 通知页第五轮：三个问题同源——label 宽度一律退成内容宽
    1) TAB 不再按「等分块 + 块内居中」推算
    前三轮以为是留白算错，实际是 label 尺寸为 SIZE_CONTENT（宽度随文本），
    117 的块宽没起作用、text_align CENTER 也就没机会生效，文字一律从块左缘排，
    于是「左贴边、右边多出约两个字」。
    改成按墨迹定位：x 直接写文字左缘 38/156/274/392，width 40 = 20px×2 字
    （fontTools 实测 advance 1000/1000），CLIP 锁宽兼容 width 生效的环境，
    不写 text_align 走默认 LEFT。左 38 = 右 38（470-432），对称。
    2) 正文折行不再依赖 LVGL 的 WRAP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
    [ha-monitor-display.yaml, page_notify.yaml]
2026-11-01 v2.0 通知页第六轮：顶栏收高、切换条四按钮、NR 侧折行、正文右留白 +12px
    1) 顶栏 h50 → h30（12px 标题撑不起 50 高，显得空，用户「改成你原来的」）。
    省下的 19px 全给正文：正文 y58 h168 → y39 h187，多出约一行。
    卡片节奏 5/30 · 4 · 187 · 4 · 32 · 4 · 49（底 320 收口）。
    2) 时间加 4 位年份：格式 2026-11-01 18:07（16 字符 ≈99px），x344 起，
    到 443，右侧仍留 27px。标题上限同步收到 24 字（288px，到 311），
    中间 33px 空隙，长标题压不到时间。ts 缺失时用设备当前时间，
    时钟没走（<2020）才退回「刚刚」。
    3) 切换条改成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
2026-11-01 v2.0 通知页第七轮：时间左移、图标换黄、TAB 再左移、折行加第三重保险 + 诊断日志
    1) 顶栏时间左移两个数字宽（12px 下 ASCII 7px×2 = 14）：
    x 344 → 330，右缘 330+99 = 429，右侧留 41px；标题 24 字到 311，中间 19px。
    2) 标题图标：mdi:bell(U+F009A) → mdi:message-text(U+F0369)，青 4FD8FA → 黄 FFD54F。
    气泡在小尺寸下比铃铛好认；黄色与 TAB 当前页的青区分开，也表示「有内容待读」。
    &mdi_glyphs 里等价替换（仍 53 个图标，不多付体积）。
    3) 切换条：四个 obj 本来就有，问题是底色 2A2A2A 与卡片 1E1E1E 太接近，
    暗屏上看不出分块。底色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
    [ha-monitor-display.yaml, page_notify.yaml]
2026-11-01 通知页标题图标改用 mdi:bell-ring-outline（U+F009F，黄 FFD54F）
    用户点名这只「响铃描边」：描边线条细，20px 下比实心铃透气，
    也比普通铃多一道「正在响」的动势，更贴通知语义。颜色保持黄。
    &mdi_glyphs 等价替换，仍 53 个图标，自检全绿。
2026-11-01 logger: 去掉 notify: DEBUG（ESPHome 禁止 tag 级别比全局更细）
    报错 'The configured log level for notify (DEBUG) must not be less severe
    than the global log level (INFO)'。ESPHome 只允许把 tag 压得更粗（如 lvgl: WARN），
    不允许放开得更细。
    改法：不加 tag 级别，通知链路的诊断日志统一用 ESP_LOGI，走全局 INFO 即可见。
    量很小——只在收到新消息、以及真的重绘时各打一两行。
2026-11-01 v2.0 通知页第八轮：切换条改四格独立卡片、条目断行、数字不劈开、TAB 右移 7px
    **关键发现**：日志证明折行一直是生效的
    入列 819字节/9行 + 重绘 label w=450 h=153（9×17）
    也就是说 LVGL 里就是 9 行。用户看到的「没有换行」，真正原因是
    上游正文是一段到底的流水（"…0Klx 1.【天气】… 2.【室内】…"），
    硬折行按像素切、序号正好落在行中间，每行又几乎占满 420px，
    于是视觉上仍是一堵墙 —— 缺的不是换行符，是**条目分段**。
    1) notify_store.h 新增 split_items()：把「空格 + 1~2 位数字 + . 或 、」
    认成条目序号，在它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
2026-11-01 v2.0 通知页第九轮：时间恢复相对格式、切换条收窄、换行根因查明（<br> 被当空格）
    **换行根因（用户提供主流程后确认，与设备端折行无关）**
    家居简报 / 尤萨洗衣 / 泰康养老 三个上游节点，正文都是
    [...].join("<br>") 拼 HTML，再走 HA persistent_notification.create。
    HA App 把 <br> 渲染成换行 → 手机上看着一行一条；
    而子流程「拼装与清洗」里 .replace(/<[^>]+>/g, " ") 把 <br> 变成**空格**，
    所以屏幕收到的是一段流水（日志 819字节/9行、160字节/2行 就是这么来的）。
    1) 清洗链新增「块级标签还原换行」：<br> / </p> </div> </li> 等 →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
    [ha-monitor-display.yaml, page_notify.yaml]
2026-11-01 v2.0 通知页第十轮：正文行头图标改「认字不认图」+ 时间右移 + 正文内边距收 5px + 未读红点做大
    **1) 图标：万能方案（用户「好多通知，好多图标，你最好想个万能的办法」）**
    逐个 emoji 建映射追不完 —— 语音指令里有 🔊🧑‍🏫⏰📌🎯📢🚶，
    系统音量里又是 ⏰✨✅💡🔶🔴🌙，每个节点各用各的。
    改成三层，越往下越万能：
    A 语义 emoji（✅❌⚠️⭐♥🔔）→ 对应 MDI 图标（颜色即语义）
    B 常见内容 emoji（☀🌙💧⚡💰📱…约 40 类）→ 对应图标
    C 兜底：emoji 一律删掉，改由 **中文标签关键词** 出行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
2026-11-01 v2.0 第十二轮：认不出的图标补彩色占位不再删 + 未读红点放到通知键右上角
    - NR 清洗：新增 scrub()，行首/【】内映射不到的 emoji 换成彩色 ●■★◆ 占位
    （与 emoji 同为全角 12px，顶住原来那一格），句中装饰性 emoji 仍直接删；
    原来一律删除会让「【🌙 休息模式】」变「【 休息模式】」，整行左移一格
    - 占位形状/颜色按码位确定性取，同一 emoji 每次一致；变体选择符/ZWJ/肤色不占位
    - 未读红点 x421→439 y271→273 9px→11px，从两字中间上方挪到「通知」右上角
    - 修 scan_glyphs.py 两处误报：ICON_CODES 表未解析导致「缺 53 个」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
2026-11-01 v2.0 第十三轮：【】一律补图标 + 时间右移 24 + 红点浅绿
    - NR：通用图标统一成 ★（MDI star F04CE，判不出语义时全用它，不再轮换 ●■◆）
    - NR：【xxx】一律有图标 —— 能按标签判词用语义图标，判不出用 ★；
    补「家居简报」词表（活动/运行/电器/能耗 等 26 个常用段落标签）
    - NR：🔶🔷 大菱形归入项目符号（还原成同色 ●，不当占位处理）
    - 通知页：时间 x 360→384（再右移 24px）
    - 未读红点：x438 y274、颜色红 FFD54F→浅绿 59D98B
2026-11-01 v2.0 第十五轮：正文左缘统一 + 溢出时顶部空一行
    - notify_render：容器 pad_all 归零、scroll_dir 锁定纵向，
    让「能不能滚」不再影响文字左边缘（不滚动时的左缘与滚动时同源）
    - 内容溢出一屏（进入自动滚动）时正文 y=20（3+一行 17px），
    滚出去的行落在空白里；不溢出时仍是 3
    - 加一条布局诊断日志（x/y/pad/scrollx/溢出/卡高），左缘再飘可直接看数字
2026-11-01 v2.0 第十七轮：【】图标全行覆盖 + recolor 标记不再被折断 + 时钟搬到通知页
    图标丢失的三条根因（都在 NR 清洗层，改完只需重导子流程）：
    - 只认「行首就是【」：带序号「1.【运行】」、整段一行「…｜【运行】…」
    这些写法整行拿不到图标。改成扫全行每个【…】逐个补。
    - 话费用的 U+F03F2 根本没并进屏幕字体 → 该行空一格，改用手图标 F011C。
    - 新增 .workbuddy/check_nr_icons.py：模板图标 → ui_font_notify 声明 → 字体
    cmap 三段比对，缺一个就报错（这类问题只能静态兜住）。
    折行（JS + notify_store.h 双端同步）：
    - 「#RRGGB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
    [page_notify.yaml, page_system.yaml]
2026-11-01 v2.0 第十八轮：图标去重/不许独占一行 + 标题不再带图标 + 正文右移下移
    图标重复（【活动】一个图标 2 个星号）
    - splitMark 原来只剥「一个」标记，两个 emoji（⭐🌟）各补一个星号 → 双星
    改成剥掉所有连续标记；tagBrk 再统一去掉残留占位符号，保证【】里只有一个图标
    星号独占一行（新闻简报）
    - wrapLine 换行助手 brk()：行尾若孤零零挂着一个图标标记，连它一起挪到下一行
    - 新增 glueIconLines()：上游本来就是「★ / 换行 / 标题」两行的，接回同一行
    - notify_store.h 同步加 pop_tail_mark()，两端规则一致
    版面
    - 顶栏铃铛图标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
2026-11-01 v2.0 第十九轮：恢复铃铛 + 标题只留纯文字 + 正文离边框统一 20px
    18 轮误读修正
    - 用户要删的是「NR 随标题带过来的图标」，不是页面自己的铃铛。
    notify_title_icon（bell-ring-outline U+F009F 黄 20px）恢复，标题回 x23
    - 标题清洗三层：
    · NR：EMOJI_ICONS 只替换正文，title 不再做图标替换
    · NR：title 收尾剥 PUA 图标 / 占位符号（★●■…）/【】/ 标记与首尾标点
    · 设备：notify_store.h 新增 strip_marks()，render 时对 s.title 再剥一次，
    空则回落「通知」
    正文位置
    - x 21→20、y 20 不变；滚动与不滚动同一套数值
    - pad 归零挪到 on_load lambda（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
    [page_notify.yaml]
2026-11-01 v2.0 第二十轮：修【】双星（正则长度上限）+ 行首星星全部去掉
    【活动】还有一个图标两颗星 —— 19 轮没修掉的真因
    - tagLine 的 /【([^【】]{0,24})】/ 上限 24 个 UTF-16 单元，而两个 emoji 的
    标签内层标记串有 27 个单元 → 整段匹配不上，tagBrk 根本没被调用，
    原文原样透传（屏上=两个星星）。上限放到 80
    - 新增 capBrkIcon：对每一对【】做最终裁剪，只留第一个标记
    （兜住超长标签、嵌套等所有漏改），保证「一个【】= 一个图标」
    新闻前的星星（用户：解决不了就不要了）
    - scrub 不再给行首补占位，只有【】内补 ——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
2026-11-01 NR 子流程改名：推送屏幕通知 → 屏幕推送
    - subflow.name 改「屏幕推送」（id hd_notify_subflow 不变，重新导入即覆盖）
    - 文件同步改名 NR子流程-屏幕推送.json，脚本/文档引用一并更新
    （sync_nr_charset.py、t2~t7.js、test_notify_fn.js、README、方案说明）
    - 子流程 info 说明改成当前真实行为：<br> 还原换行、emoji 只在【】里补图标、
    行首星号去掉、425px 硬折行、标题只留纯文字
    - W://esphome 旧文件已删，只留新名
2026-11-01 NR 子流程类别：HA Monitor → 子流程
    - subflow.category 改「子流程」（Node-RED 侧边栏分组名），
    id hd_notify_subflow / name 屏幕推送 均不变，重新导入即覆盖
    - 跑 sync_nr_charset.py 重生成函数体，确认 category 未被冲掉
    （脚本只改 func 节点，其余字段原样保留）
    - 回归 t5/t6 通过
2026-11-01 NR 子流程：类别改「子流程」+ 图标青色铃铛
    - subflow.category: HA Monitor → 子流程
    - subflow.color: #4FD8FA（项目标识青，与 TAB 当前页/标题图标同色）
    - subflow.icon: font-awesome/fa-bell（与通知页顶栏铃铛一致）
    - id hd_notify_subflow / name 屏幕推送 不变，重新导入即覆盖；
    sync_nr_charset.py 只改 func 节点，category/color/icon 不受影响（已跑一遍验证）
2026-11-02 GitHub 上传准备：重写 README + 新增 CHANGELOG
    - README.md 重写为面向仓库首页的完整版：硬件/引脚、API v0.9.0 与
    Mqtt v1.x 两条版本线、两条快速开始（含 secrets.yaml 模板）、
    数据流、功耗实测、开发踩坑、文档索引
    - CHANGELOG.md 新增：v1.1.1 详细（续航优化三项 + 20mA 实测）、
    v1.1.0 / v1.0.1 / v1.0 简要、API v0.9.0（前身版本）
    - .workbuddy/pack_api_090.py：API 包打包+独立解包 MD5 校验
    （API v0.9.0.zip 8 条目 6.64MB，5 YAML + 2 字体 + README，
    页面文件按主配置 !include 进 ui/ 子目录）
2026-11-02 脱敏：broker/username 收进 !secret（v1.1.1 上传包重制 + v2.0 主配置同步）
    - 泄漏发现：项目外网MQTT方案说明.md 97/161 行含**真实 MQTT 密码明文**，
    主配置 59-61 行明文 broker 域名 + 用户名
    - v1.1.1 包重制（同名覆盖，10 条目不变，独立解包 MD5 全一致）：
    · 主配置 broker/username → !secret mqtt_broker / mqtt_username
    · 文档密码/域名/用户名全替换（域名→home.example.top，示例用户名→your-mqtt-username）
    · 包内 README 复查无泄漏
    - v2.0 主配置同步切 !secret（secrets.yaml 三键齐备，编译零改动，已同步 W:）
    - 工作区说明文档同款脱敏；README secrets 模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
    [ha-monitor-display.yaml]
2026-11-02 gitignore 补 ui/（本地镜像目录不入库）
2026-11-02 feat(v2.1): 5 项控制接入 MQTT，屏幕带出门仍可远程调亮度/熄屏/开关
    - 设备端新增 mqtt.on_message 订阅 cmd/{light,bright,sleep,autosleep,wake}（QoS1 + retain）
    - 新增 mqtt_pub_state 脚本：控制量变化或开机 20s 后回发状态帧到 esphome/.../state
    - 新增 ha/monitor_display_control.yaml：5 个 HA mqtt 实体（1 灯 + 2 数值 + 2 开关）
    - 控制动作复用现有实体逻辑（滑块 set_action / switch / 休眠脚本），不引入新状态变量
    - README 补「远程控制」章节与目录结构；CHANGELOG 增加未发布条目
2026-11-02 docs: 屏幕尺寸更正为 3.5 寸（320x480，非 4.0 寸）
    - README 简介与硬件表；焊接指南标题/模组识别表
    - tab_bar.yaml 注释 ppi 换算改为 3.5寸 ≈165ppi / 1mm≈6.5px
    - 移除已不匹配的 lcdwiki 4.0inch 参考链接，改为「以本文件表格为准」
2026-11-02 style(dashboard): 行3 音量改固定蓝色；电器/能耗四行行序对齐网络页
    - 居家模式行的音量百分比不再随模式字变色，固定 蓝 5AA9FF（语音语义色，
    与在家橙/离家红/休息紫/影音黄四色均不撞）
    - 电器动态四行图标：第3行空调 蓝→绿 59D98B，第4行电器 绿→蓝 5AA9FF
    - 今日能耗四行图标：第3行用气 蓝→绿，第4行用电 绿→蓝
    - 两块四行行序统一为 黄FFB74D/紫B39DFF/绿59D98B/蓝5AA9FF（与网络页一致）
    - 同步 W:/esphome/ui/page_dashboard.yaml；esphome config 校验通过
2026-11-03 fix(ha): mqtt light 状态模板键名修正 + 项目目录整理
    - monitor_display_control.yaml: light 的 value_template 不是合法键，
    改 state_value_template（修复 HA 报「配置无效」，远程开关恢复）
    - 目录整理（git mv 保历史）：页面/公共件归 ui/，头文件归 include/，
    HA 侧包归 ha/，方案文档归 docs/，硬件资料+整机照片归 hardware/，
    历史发布包归 releases/；主配置 includes 路径 ui/→include/
    - W:/esphome 同步新结构，esphome config 校验通过
    - README 目录结构两处更新
    [ha-monitor-display.yaml, page_dashboard.yaml, page_network.yaml, page_notify.yaml]
2026-11-03 chore: NR 屏幕推送子流程 JSON 归入 ha/（随 HA 侧资源统一管理）
    - docs/ 保留纯方案文档；ha/ 现含推送自动化 + 远程控制包 + NR 子流程导出
    - W:/esphome 真机目录只留编译件（主配置/secrets/ui/include/fonts），
    文档与 NR json 不再放真机目录
2026-11-03 feat(v3.0): 推送包槽位表化草稿（第一档，未启用）
    - 实体 ID 集中到 automation variables 的 SLOT 槽位表（49 个槽），
    payload 只引用 SLOT.xxx，换实体不再需要读懂模板
    - id/alias 带 _v3 + initial_state: false，可与正式版共存试运行
    - screen_bright 保持硬编码（屏幕自身背光，由控制包创建）
    - 静态验证：49 槽全引用、entity_id 形态合法、JSON 键序与 v2 一致
2026-11-03 docs(hardware): 3.5寸屏数据表入库 + PCB 设计要点文档
    - 3.5寸SPI屏幕参数1~4.jpg（SKU MSP3526）四张数据页入库
    - 新增《3.5寸屏幕规格要点（PCB设计用）》：参数/尺寸/引脚网络表/
    电源核算（背光实测口径 95mA，系统 ~500mA@5V）/打板清单/BQ25606 集成位
    - 焊接指南：供电标称与背光电流对齐数据表（5.0V / 95mA），交叉引用新文档
    - 14 针定义与数据表逐针核对一致
2026-11-03 feat(v3.0): 推送包槽位表化转正（用户已确认）
    - 实体 ID 集中到 automation variables 的 SLOT 槽位表（49 槽，带中文注释），
    payload 与 v2 逐键一致，MQTT/固件零改动
    - 草稿标记（_v3 id / initial_state:false）已去除，覆盖正式文件
    - W:/packages 同步新版并复验解析
    - CHANGELOG 增加 v3.0 第一档条目
2026-11-03 fix(v3.0): 推送包 payload Jinja 语法错误修复 + SLOT 引用加固
    根因：v3 转正时在 {{ {...} | to_json }} 字典字面量内部放了一条 {#- -#} 注释，
    Jinja 不允许表达式内出现注释（unexpected char '#'），HA 装载自动化即报
    「template value should be a string at 'actions[0].data'」。
    - 该注释移到表达式外的文本层（并入既有注释块）
    - payload 首行加 {%- set SLOT = SLOT | default({}) -%} 兜底
    - 59 处 SLOT.xxx 引用统一包装 | default('')：HA 装载期预校验（无 SLOT 变量）
    可优雅渲染；用户槽位表填错键名时仅该字段显示 --，不再拖垮整条推送
    - 本地 jinja2 编译+渲染模拟验证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
2026-11-03 docs(changelog): 补 v3.0 修复记录
2026-11-03 chore: case/ 外壳模型暂不入库，待打印件验证后再推
2026-11-03 feat(v3.0): 第二档网页配置生成器（tools/）
    - 单文件 HTML，零依赖，部署 /config/www/ 经 /local/ 打开（同源调 HA API 无跨域）
    - 基础配置 9 项 → secrets.yaml（ap/web/api/ota 密码一键随机，api_key 按 ESPHome base64url 32 位生成）
    - 49 槽位按 8 组分类填写：期望实体类型校验、datalist 联想、连 HA（长期令牌）拉实体列表按域过滤
    - 输出完整 monitor_display_push.yaml（SLOT 表已填好），下载即替换 /config/packages/
    - 输入 localStorage 自动保存 + 导出/导入 JSON
    - 验证：模板回填作者实体与正式文件 SLOT 字典完全一致；jinja2 编译通过；
    双阶段渲染（无 SLOT 兜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
2026-11-03 feat(v3.0): 生成器槽位改按屏幕版面排序
    - 49 槽位重排为 11 组：第1页(家居) 行1~行5 → 第2页(网络) 行1~行3，
    行内从左到右、从上到下（据 ui/page_dashboard.yaml / page_network.yaml 实际坐标）
    - 组标题带页码徽标；槽位说明补充屏幕标签（如 在家/客人/电灯/前扇）
    - 注明系统页/通知页不使用数据槽位
    - 回归验证：49 键无重复、与正式文件 SLOT 字典完全等价、payload 一致、
    jinja2 双阶段渲染 54 键合法 JSON
2026-11-03 docs(v3.0): 生成器面向新用户补充使用说明
    - 顶部新增「使用前必读」卡：数据流一句话说明 + 改哪里/替换哪个文件/
    要不要重新编译烧录 对照表（换实体=只重载自动化；改 secrets=要重新烧录）
    - 下载位置、留底建议、留空与类型不符的后果、令牌安全等注意事项
    - 11 组槽位每组新增「取值说明」：数字/文本/开关型要求，
    高亮标注属性取值槽位（weather.temperature、stock.sh000001.changeRatio、
    home_mode volume 属性、fan.percentage）及实体必须含该属性的约束
    - 回归：语法检查通过，49 键无重复，11 组说明齐全
2026-11-03 fix(v3.0): 基础配置输入框未绑定 input 事件，右侧输出不实时更新
    - 9 个 secrets 输入框与 ha_base 补挂 input 监听（此前只有随机按钮
    主动触发 onChange，手打内容输出区/校验/localStorage 均不更新）
    - ha_base 输入同步写入 state.ha.base 使其可被 localStorage 持久化
2026-11-03 feat(v3.0): 左侧板块底色区分 + 底部三页屏幕版面模拟图
    - 去掉页头「第二档」字样，仅保留 v3.0
    - 左侧四板块按底色区分：必读(灰蓝)/基础配置(蓝)/连HA(绿)/槽位(橙)，
    标题序号徽标同步换色
    - 新增屏幕版面示意：480×320 等比例，坐标取自 ui/page_dashboard.yaml /
    page_network.yaml / page_system.yaml 实测值
    第1页 23 格 + 第2页 26 格 = 49 槽位全覆盖；第3页标注不使用槽位
    - 联动：点方格 → 滚动并聚焦对应槽位输入框；输入框聚焦 → 该格红框高亮；
    格内显示当前实体短名，悬停显示完整 entity_id，留空格置灰虚框
    - 校验：语法通过、49/4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
2026-11-03 feat(v3.0): 屏幕模拟图移到右侧常驻，输出区下移
    - 右列改为常驻「屏幕版面」卡：三页页签切换（家居/网络/系统），
    只显示当前页，避免三张竖排过长
    - 点左侧槽位输入框 → 右侧自动切到该槽位所在页并红框高亮；
    点模拟图方格 → 滚动定位到左侧输入框
    - 下载区（secrets / push）移到页面底部整幅两列，预置于部署说明与配置备份
    - 修复：第2页「外网IP/WAN」组 page 字段误写为 1（徽标显示成第1页）
2026-11-03 fix(v3.1): 生成器版面样式复原 + 概览页在线设备两格通用化
    版面（生成器）：
    - 上一版替换 CSS 时误删 60 行基础样式（.grp/.slot/.badge/.hint/input/button/pre
    /table.howto 等），导致左侧板块与槽位区排版错乱；已从 b3a84f4 原样恢复
    在线设备两格通用化（原 Nova13 / Nova12 名称固化在固件三层）：
    - JSON 键 device_a_online / device_b_online（原 nova13 / nova12）
    - 固件 hd_/ha_ 前缀同名调整；新增 hd_device_a_name / hd_device_b_name（std::string）
    - 新增文本槽位 device_a_name / device_b_name：屏幕显示名由 HA 下发，
    留空回退「设备1 / 设备2」，超 74px 自动截断（long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
    [ha-monitor-display.yaml, page_dashboard.yaml]
2026-11-03 fix(v3.0): 随机按钮横排 + 生成结果移入右列底部
    - 基础配置行内 input 设 width:100% 将同行按钮挤成竖排两字；
    改为 .f .row input{flex:1;width:auto} + 按钮 white-space:nowrap
    - 「生成结果」（secrets/push 输出、部署说明、配置备份）从页面底部
    移入右列、位于屏幕版面下方；右列改为粘性+列内自滚动
    （max-height:calc(100vh-24px)，窄屏媒体查询还原为普通流）
    - out-grid 改单列、pre 限高 300px 适配窄列宽
2026-11-03 feat(v3.1): 模拟页面字号统一 12px + 设备格改「名称在上、状态在下」
    生成器：
    - 屏幕模拟图字号去掉 cqw 缩放，统一 12px（与页面正文同号），
    实体短名 11px、页签 12px、说明 11px
    - 双键格（设备 A/B）改为上行名称、下行在线状态实体，与实机一致
    固件 ui/page_dashboard.yaml：
    - 两格重排为两行：名称 align top_left x:26 y:6 width:118 long_mode:DOT（16px），
    状态 align bottom_left x:26 y:-6（12px ui_font_small）
    - 名称仍由 HA 下发（device_a_name/device_b_name），固件内不含具体设备名
    - esphome config 校验通过
2026-11-03 fix(v3.1): 设备格恢复单行(名称+状态同行, 默认 Nova13/Nova12) + OTA 去密码复用 api_key + MQTT 端口可配
    [ha-monitor-display.yaml, page_dashboard.yaml]
2026-11-03 fix(v3.1): 设备名回退 Nova13/Nova12 + 生成器页头标题居中、说明并入必读
2026-11-03 style(generator): 基础配置卡固定两列对齐，MQTT端口标签收短
2026-11-03 docs(generator): 重写使用前必读开头（本页面为主语，纠正屏幕类型）
2026-11-03 fix(generator): 槽位值统一加引号(含#/:值被截断) + 两列对齐 + 过时计数, CHANGELOG 记录自检结果
2026-11-03 docs(generator): 令牌说明改为准确表述(仅页面内存, 刷新即清空)
2026-11-03 docs(generator): secrets.yaml 改为合并指引，禁止整份覆盖(全 HA 共用)
2026-11-03 style(generator): 必读三段改为等距序号条目，统一 code 字体与行高
2026-11-03 fix(v3.2): 通知唤醒后保持 15s 不熄屏(ui_hold_until), 修「闪一下就灭」
    [ha-monitor-display.yaml]
2026-11-03 style(generator): 统一键名样式(等宽+浅底+加粗), 连接HA卡补中文名加粗与键名
2026-11-03 docs(generator): 设备格说明改为「右侧上/下格 + 格内一行三项」，同步 15s 保持修复到 W 盘
2026-11-03 feat(v3.2): OTA 显式加密复用 api_key, 拒绝明文上传, 消除 Dashboard 提示
2026-11-03 style(generator): 系统页 SSID/IP 拆两条对应左右格, TAB 字号 12→20px 对齐屏幕 ui_font_large
2026-11-03 fix(v3.2): OTA 改用空 encryption: 块继承 api_key, 消除 Dashboard 两条提示; 模拟图 TAB 16px
    [ha-monitor-display.yaml]
2026-11-03 docs(hardware): 电源方案落定 IP5406(已下单), 记录 IP5306 拔线重启成因与 IP5406 验收标准/回退路径
2026-11-03 style(generator): 移动端适配——槽位堆叠/表格横滚/模拟图字号容器缩放/h2 flex 对齐
2026-11-03 fix(generator): 移动端媒体查询块移至样式表末尾——首版插在中段被同权重基础规则覆盖未生效
2026-11-04 feat(IP5406): 并入 5V UPS 电源板子项目（KiCad 工程/BOM/下单指引 51 文件），交接文档路径更新
    [BOM_full.csv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]
2026-11-04 docs: CHANGELOG 补记 IP5406 子项目并入
2026-11-04 docs(IP5406): 已在嘉立创下单（11-04 确认），待办首项改为等回板收料
2026-11-04 feat(v3.3): 关屏时来通知直接跳到通知页再唤醒，不再停在原页面
2026-11-04 docs: CHANGELOG 补记 v3.3 通知直跳通知页
2026-11-04 feat(v2.1): MQTT 远程控制 5 实体改英文名（HMD 前缀），unique_id 不变；README 对照表同步
2026-11-04 docs: CHANGELOG 补记远程控制实体英文化
2026-11-04 feat(v2.1): 去掉 5 个远程实体中 4 个的 entity_category: config，回归常规控件区
2026-11-04 docs: CHANGELOG 补记 entity_category 移除与部署
2026-11-04 refactor(v2.1): 设备名改 HMD Remote，实体名去掉冗余 HMD 前缀（entity_id 由设备名+实体名生成）
2026-11-04 docs: CHANGELOG 补记 HMD Remote 设备名与实体名去前缀
2026-11-04 feat(ha): 新增远程控制 Lovelace 卡片片段（entity_id 已在真机确认）
2026-11-04 docs: 远程控制链路外网实测通过（亮度/超时/开关三项）
2026-11-04 docs(hardware): 补充电源架构实拍——辰鱼 2000mAh 电池组 + IP5306 模块（Type-C 口未固定到壳）
2026-11-04 docs(hardware): 新增「当前实物形态」一节，按实拍核对电池/电源模块/充电口状态与装壳待办
2026-11-04 docs(hardware): INA226 电池监测模块选购与接线要点（R100=0.1Ω 可直接用，量程819mA，待下单）
2026-11-04 feat(ha): 屏幕控制卡片改为 Mushroom 风格（template-card + number-card 滑块两列开关），对齐本机既有卡片写法
2026-11-04 style(ha): 屏幕控制卡片改 2 列网格 3 行布局，对齐概览页 mushroom-template-card 观感
2026-11-04 style(ha): 亮度整行跨列 + 其余 2x2，标题统一四字（屏幕亮度/屏幕开关/通知亮屏/熄屏超时/自动休眠）
2026-11-04 style(ha): 屏幕亮度改用 mushroom-number-card slider 模式，带可拖动拉动条
2026-11-04 docs(readme): 新增整机实拍四页（家庭/网络/系统/通知），补 hardware 真机效果图
2026-11-04 掌控面板：手机优先第三界面（5视图 YAML+预览，待确认后入 HA）
2026-11-05 屏幕镜像：五格小字号/电器总量/网络单位+风扇温度/屏幕控制五格/通知图标还原/SSID公网兜底
2026-11-05 镜像页：五格图标对齐/风扇删温度计图标/屏幕控制移通知页两行；修复 html-template-card 订阅泄漏（不定时刷新根因）
2026-11-05 镜像页：屏幕控制块与通知区间距改页间距；图标统一为文字字号
2026-11-05 镜像页：四页首行 14px；页间距移到屏幕控制与 TAB 之间（TAB 归属通知页）
2026-11-05 镜像页：屏幕控制6格3+3移家居页顶部(14px)+MQTT心跳在线检测(cloud-off断云)；页首行14→12px
2026-11-05 镜像页：6 格控制块与家居首行之间加页间距
2026-11-05 镜像页：6 格重排(屏幕|屏显|亮屏/休眠|亮度|超时)；新增四页分页截图脚本并存 hardware/
2026-11-05 镜像页：6格重排（亮屏|屏显|屏幕）+ 风扇列字号10px
2026-11-05 镜像页：ha-card 行内 padding:16px 用 !important 压掉，去顶部空行
2026-11-05 掌控改版：全 widget 左右结构紧凑两行；车TAB并入此刻；安防监控改在线状态
2026-11-05 掌控二轮：TAB重排+页长对齐能源(±2%)；房间整块分组；能源费用概况置顶
2026-11-05 此刻：车辆合并为3行，空出行放Nova13/Nova12在线状态
2026-11-05 掌控安防页：监控置顶，顺序 监控→环境告警→窗帘→门
2026-11-05 掌控四轮：房间彩色分块强化、餐厅借用客厅温湿度、阳台换新实体、此刻头条摘要上移
2026-11-05 掌控定稿：四页统一分块+语义色统一；安防总结置顶；推送至 control-panel 面板
2026-11-05 掌控：区块内行间细分隔线；html 卡行内 padding:16px 统一压掉
2026-11-05 掌控：问候语 user 改 user.name（HA 中 {{ user }} 渲染为空）
2026-11-05 掌控：块内卡片统一芯片层次（深底+细边框+圆角），与监控块一致；去行线
2026-11-05 掌控七轮：标题居中；家居与手机对调；费用去时间；房间防折行+去提示；总概加标头
2026-11-05 掌控八轮：区块标题再下移；灯按钮去掉路数前缀
2026-11-05 chore(ha): 掌控/屏幕镜像面板 YAML 已入 HA Lovelace，删除本地副本（git 历史可找回）
2026-11-07 v2.2.0 AUDIO：接入 MAX98357A I2S 数字功放 + 双 pipeline + 内置音效
    - i2s_audio(BCLK=GPIO47 / LRC=GPIO48) → speaker(i2s_dout=GPIO38, mono 48k)
    - speaker mixer 合成 media / announcement 两路（ESPHome 要求两条 pipeline
    不能共用同一 speaker 实例），media_player 走 FLAC 由 HA 侧转码
    - 内置 sounds/ding|notify|alarm.wav（48k/mono/16bit，共 121KB），
    断网或 HA 宕机也能响；配 3 个 template button 供自动化调用
    - SD 脚 GPIO21 由 interval(1s) 监控 is_running()，空闲 3s 拉低 → 功放待机 <1µA
    - volume_max 压到 70%：4Ω3W 满量程峰值 1.26A@5V，3.99V 电池撑不住
    - task_stack_in_psram / buffer 120KB：大块内存落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
2026-11-07 docs(IP5406): 补实测排障记录与 IP5407 官方手册 V1.3
    - 根因坐实：KEY(J2-2) 悬空 → 20µA 灌开路判电池 −15℃ → 停放电（>1.32V 同时停充电）
    补 51K 到 GND 后 VOUT=5.09V 稳定
    - J4 短接帽接触不可靠 → 焊死后输出通路正常
    - 未解：充电时拔 VIN 必重启，VOUT 5.09→3.99→5.09 且黑屏 1s
    = 跌穿 4.2V 超 30ms 触发 TUVD，芯片 1s 打嗝重启；插 VIN 时升压是关的，
    属芯片内部行为，改板修不掉
    - rev1.6 待补：KEY-GND 51K 焊盘、J4 铺铜直连、VOUT 大电容位
    - 存 IP5407 手册（与 IP5406 引脚完全一致，实焊为 IP5407）
2026-11-07 v2.2.1：I2S 换到 GPIO39/40/41（避开板载 WS2812），删 3 个试音按钮
    根因：原选的 47/48/38 正是 DevKitC-1 板载 WS2812 彩灯的引脚
    （v1.0=GPIO48 / v1.1=GPIO38）—— I2S 位流被 WS2812 误解析成纯白常亮，
    同时给数据线挂了采样电容负载；若板子是 WROOM-2(N16R8V)，47/48 还在
    VDD_SPI 1.8V 域，驱动 MAX98357A(VIH=1.3V) 余量过小。
    - BCLK 47→39 / LRC 48→40 / DIN 38→41，SD 仍 GPIO21
    - 39/40/41 是 JTAG 复用脚，ESPHome 不用 JTAG（UART/OTA 烧录），可安全占用
    - 删 Play Ding/Notify/Alarm 三个 template button：只是手动试音键，与
    media_player 实体重复；自动化直接调 media_player.speaker.pl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
2026-11-09 远程控制设备改名 HA Monitor Remote（识别旧屏，与 Pocket 分开；object_id 固定 entity_id）；IP5406 收录 ES3C35P 原板电源电路参考
2026-11-09 撤销 object_id：MQTT YAML 手动配置不支持该字段，改为注释说明 entity_id 生成规则
    [BOM_full.csv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]
2026-11-11 修复 MQTT 传感器 Invalid state message：last_notify 状态去配色标记并截断 250 字符（超 255 上限），原文保留在属性 payload
2026-11-12 UI 目录改名 ui_ha_monitor（与口袋版 ui_pocket 对称）
    11-12 拆分后两个项目各占自己的页面目录，避免 pocket 的 page_system（含电池段）覆盖墙屏版导致 bat_volt/bat_pct/power_state 缺失。主配置 packages 指向 ui_ha_monitor/，README 同步。
    家居页电器动态四个总数改为实体动态取值：电灯/窗帘/空调/电器 不再写死 36/6/4/20，改取统计传感器属性 light_all_count / curtain_all_count / climate_all_count / equipment_all_count（经 payload 字段 *_all → globals hd_*_all），取不到时回退 34/6/4/20。实际总数 34/6/4/20（原 36 为错值）。
